fredrikr79/TDT4295-datamaskinprosjekt/mcu/hexMCU/host/test.png

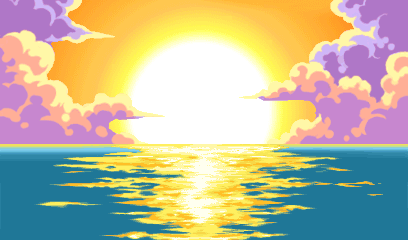
mcu/hexMCU/host/test.png
