fredrikr79/TDT4295-datamaskinprosjekt/documentation/slides/images/noita-background.png

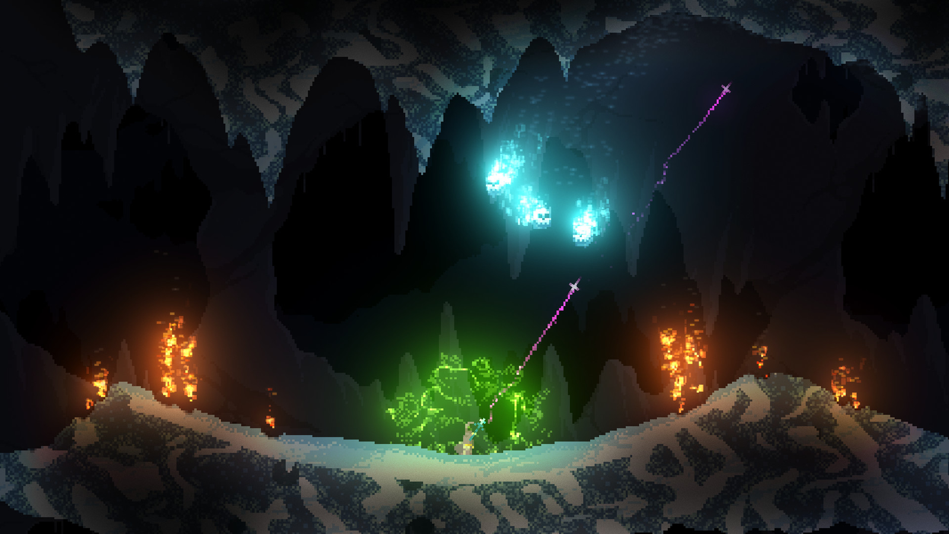
documentation/slides/images/noita-background.png
