fredrikr79/TDT4295-datamaskinprosjekt/README.md

## Structure

### MCU

The source code for the microcontroller

### FPGA

The source code for the FPGA

### PCB

The schematics for the PCB
