fredrikr79/TDT4295-datamaskinprosjekt/pcb/assets/APTF1616LSEEZGKQBKC/APTF1616.STEP

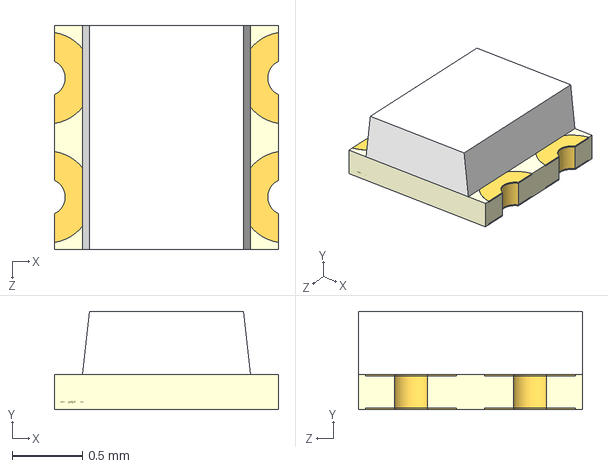
[picture p3: CAD file, 2026-09-30]
pcb/assets/APTF1616LSEEZGKQBKC/APTF1616.STEP
1.60 x 0.7 x 1.60 mm
