fredrikr79/TDT4295-datamaskinprosjekt/pcb/assets/L77HDE15SD1CH4FVGA/L77HDE15SD1CH4FVGA.step

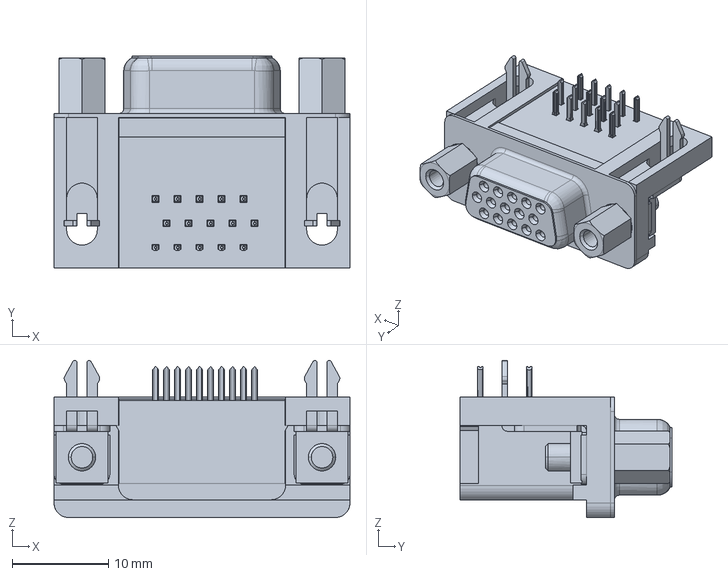
[picture p4: CAD file, 2026-09-28]
pcb/assets/L77HDE15SD1CH4FVGA/L77HDE15SD1CH4FVGA.step
30.8 x 22.1 x 16.3 mm
