fredrikr79/TDT4295-datamaskinprosjekt/pcb/assets/sd_card_model.stp

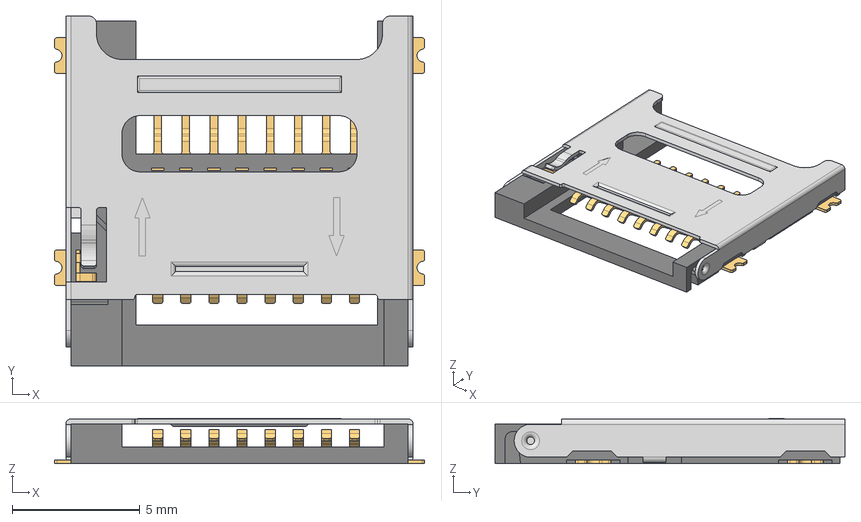
[picture p5: CAD file, 2026-09-29]
pcb/assets/sd_card_model.stp
14.5 x 13.7 x 1.77 mm
693072010801_PIN x 8
693072010801_PATTE x 3
693072010801_CACHE
693072010801_PATTE_SPE
