fredrikr79/TDT4295-datamaskinprosjekt/pcb/assets/ul_TPS54294PWP/PWP0016C.stp

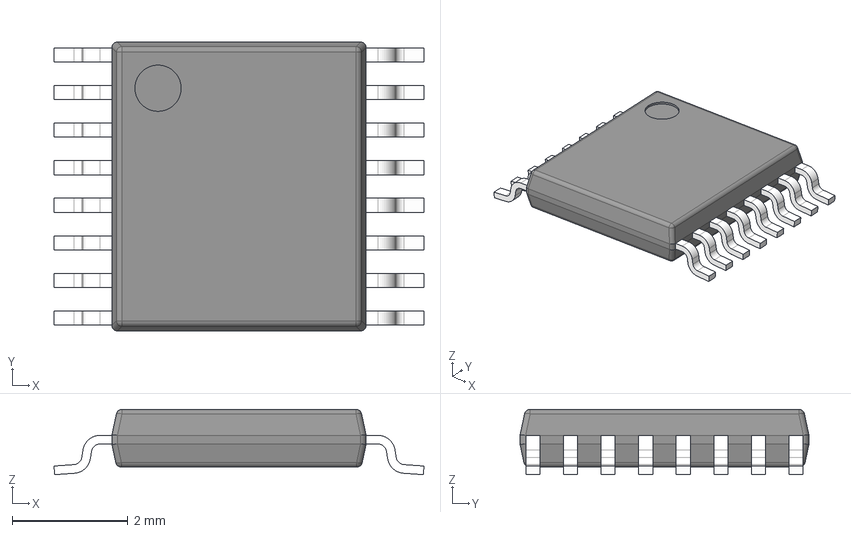
[picture p6: CAD file, 2026-09-28]
pcb/assets/ul_TPS54294PWP/PWP0016C.stp
6.40 x 5.00 x 1.13 mm
BODY-TSSOP
LEAD-TSSOP x 16
PIN1
DAP
