fredrikr79/TDT4295-datamaskinprosjekt/pcb/assets/FTFTG256_XIL.step

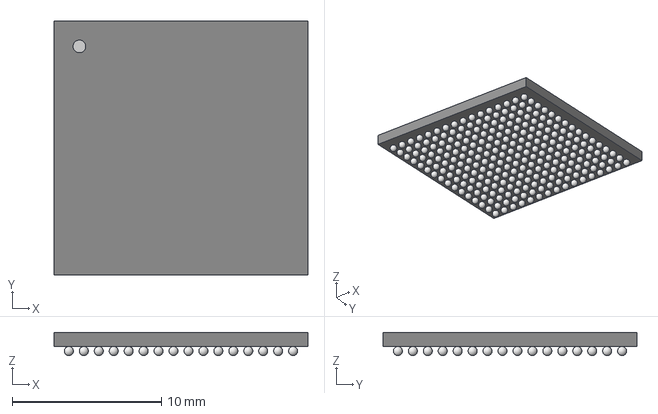
[picture p7: CAD file, 2026-09-29]
pcb/assets/FTFTG256_XIL.step
17.0 x 17.0 x 1.55 mm
