fredrikr79/TDT4295-datamaskinprosjekt/pcb/assets/usb_c_12401826E412A/12401826E412A.step

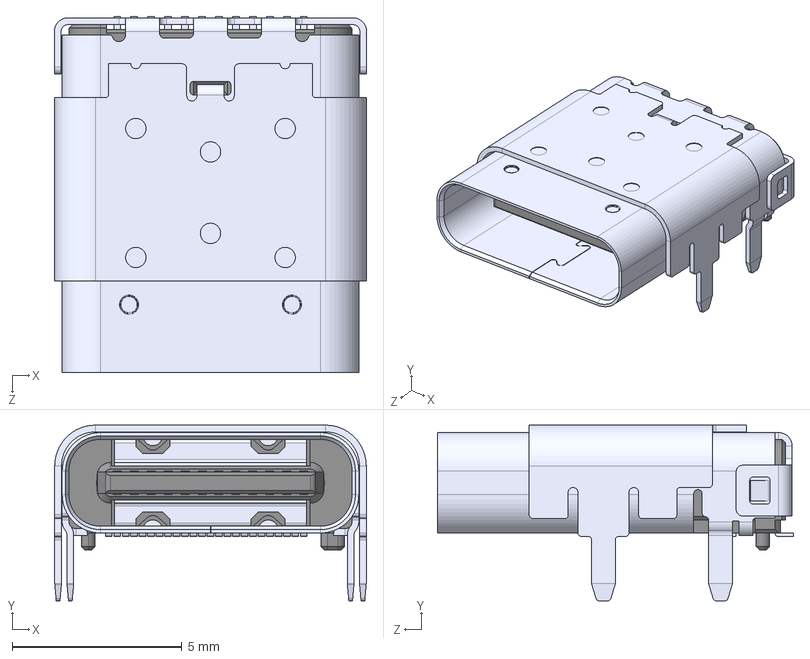
[picture p8: CAD file, 2026-09-11]
pcb/assets/usb_c_12401826E412A/12401826E412A.step
9.20 x 5.18 x 10.5 mm
