fredrikr79/TDT4295-datamaskinprosjekt/(list of files, cad)

Other CAD files:
pcb/assets/ul_TPS54325PWP/PWP0014K.stp
