fredrikr79/TDT4295-datamaskinprosjekt/mapconstructor/src/full/start.png

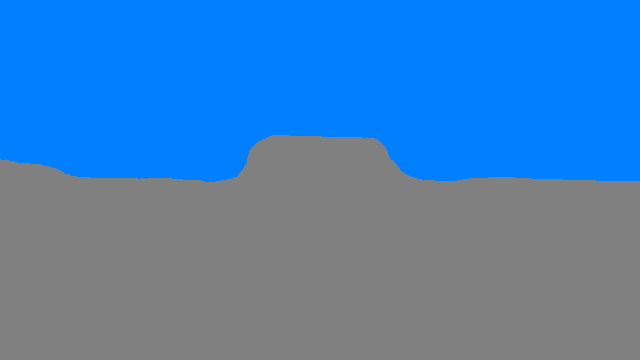
mapconstructor/src/full/start.png
