fredrikr79/TDT4295-datamaskinprosjekt/pcb/tdt4295.pdf

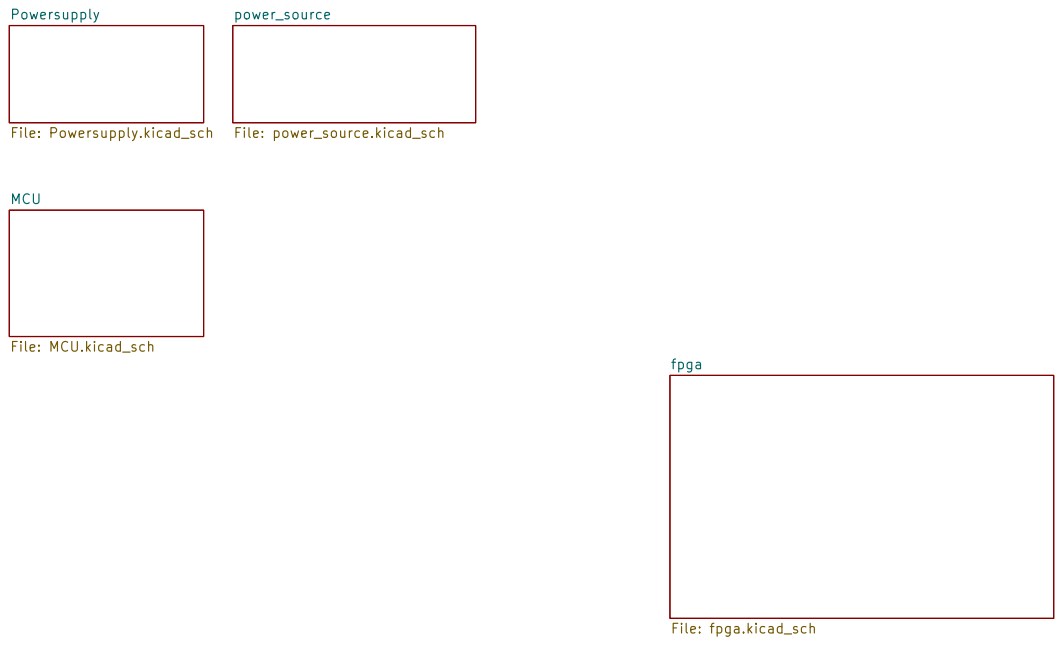
[picture p10: page 1]

File: MCU.kicad_sch Powersupply File: Powersupply.kicad_sch

Size: A4 | Rev:
KiCad E.D.A. 10.0.4 | Id: 1/6

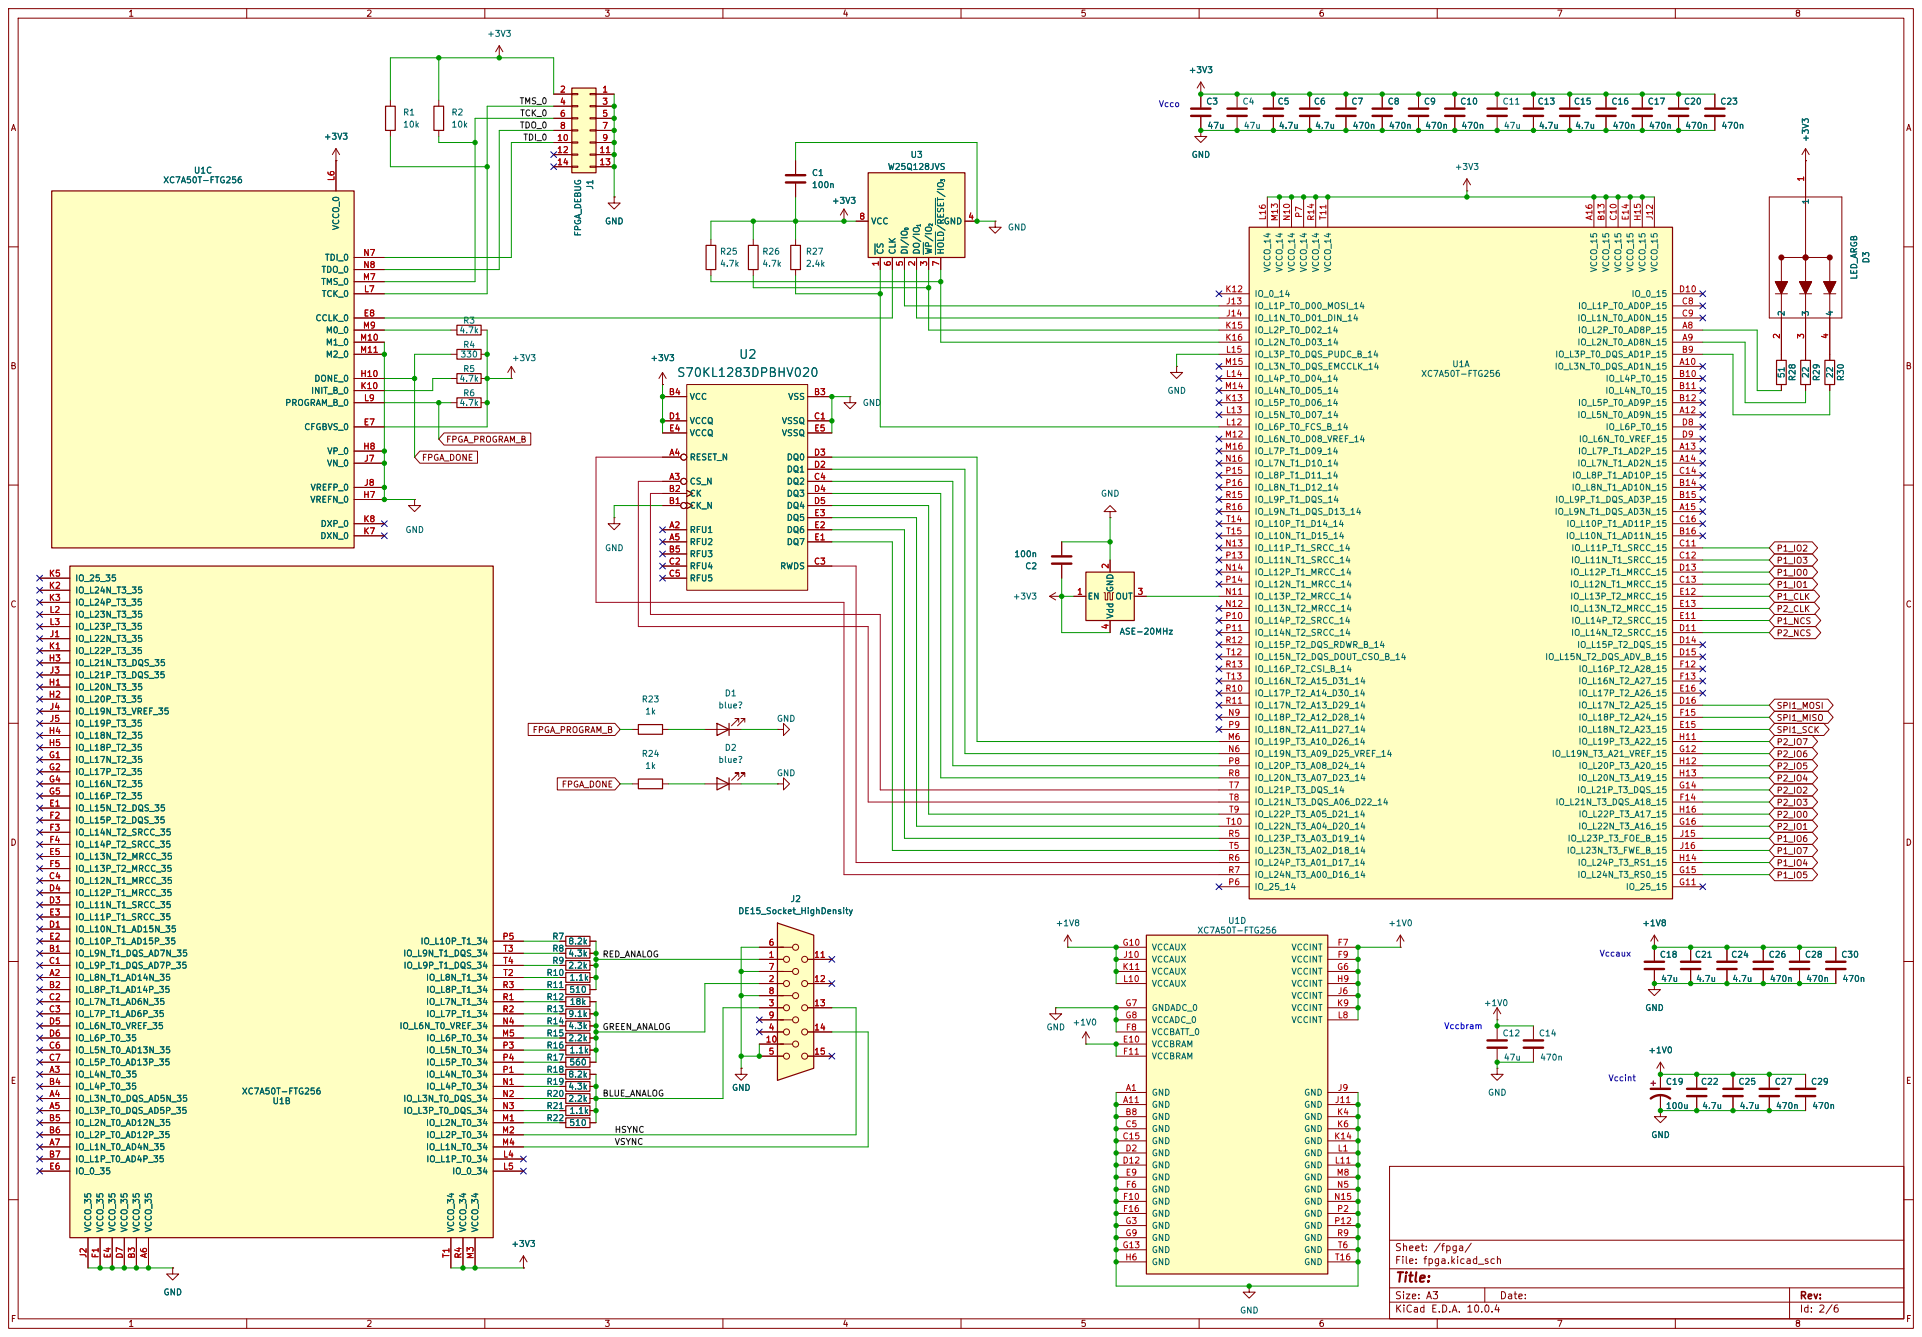
[picture p11: page 2]

TCK_0 6 6 | | 5 5
TDO_0 8 8 | | 7 7
TDI_0 10 10 | | 9 9

1 DO/IO1 2 WP/IO2 3 GND 4 DI/IO0 5 CLK

IO_L1N_T0_D01_DIN_14 J14

IO_L21N_T3_DQS_A06_D22_14 T8
IO_L22P_T3_A05_D21_14 T9

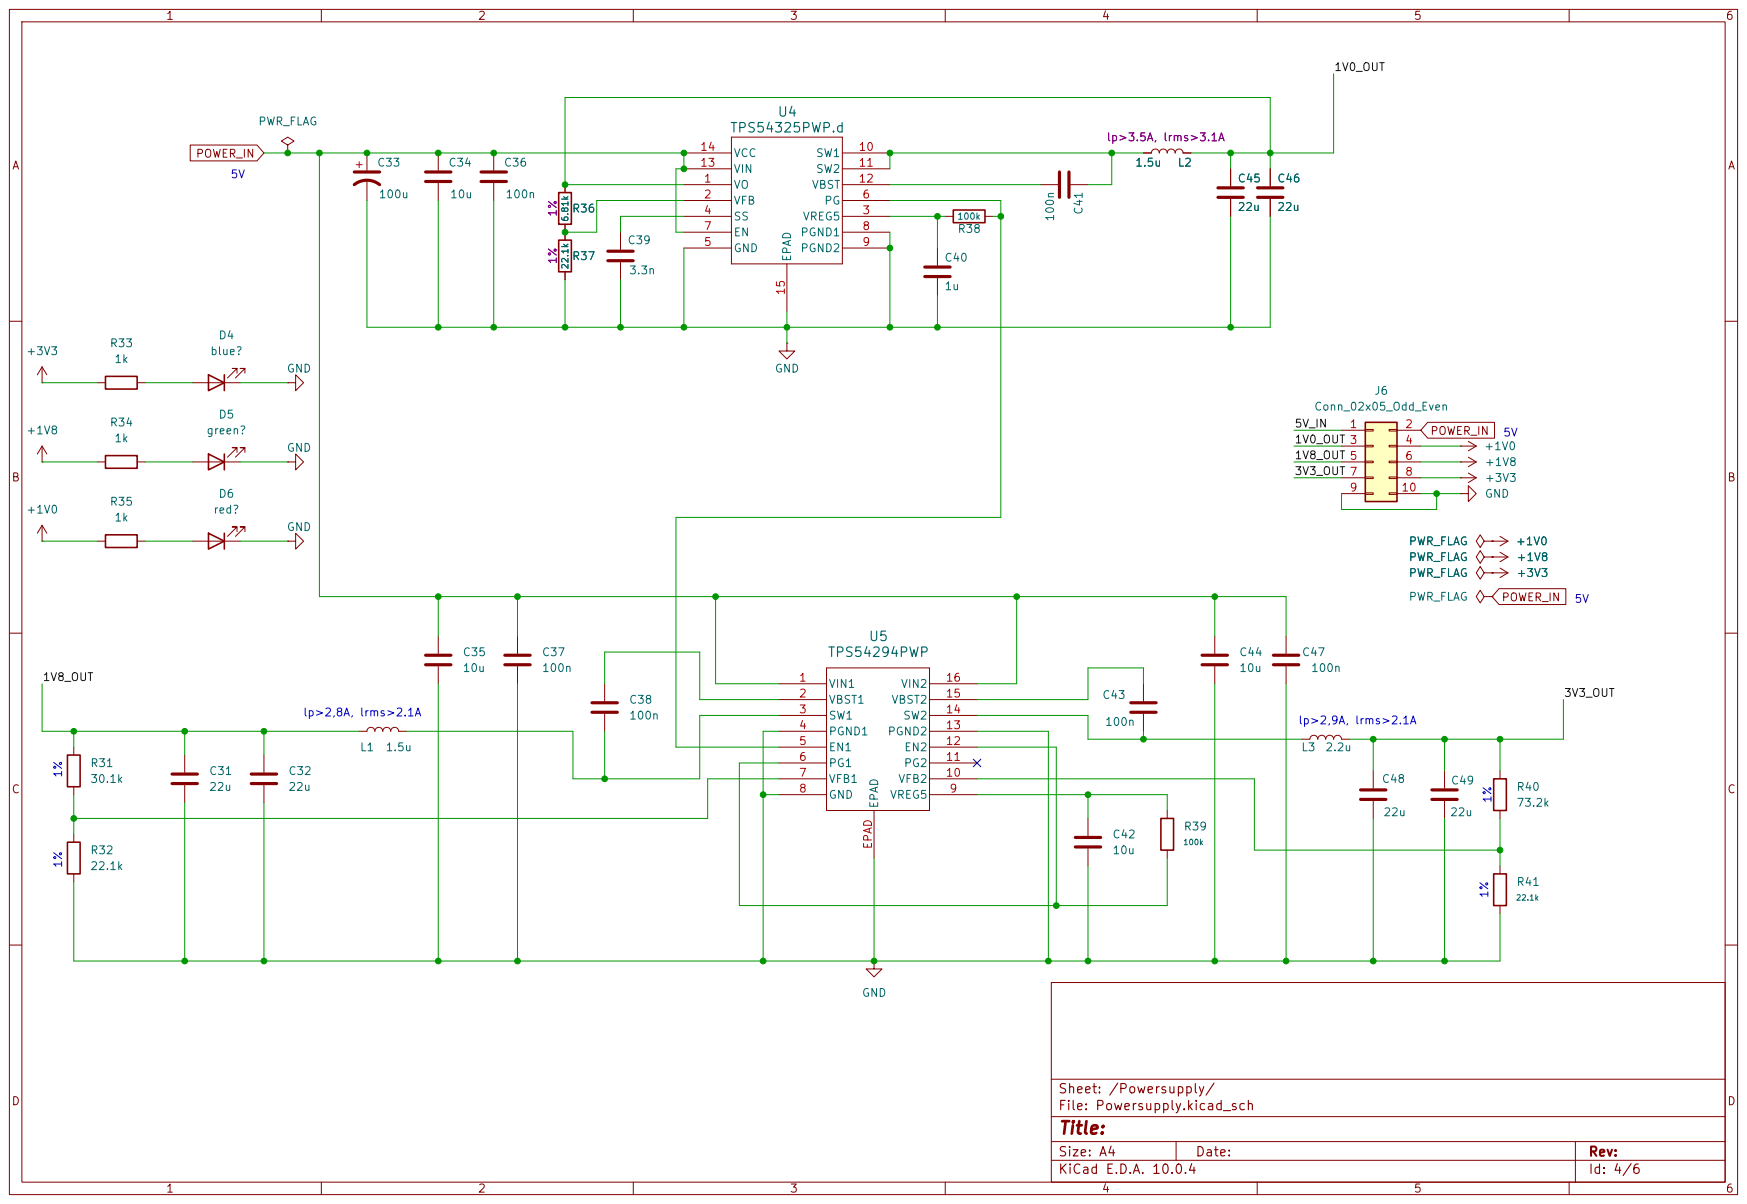
[picture p12: page 3]

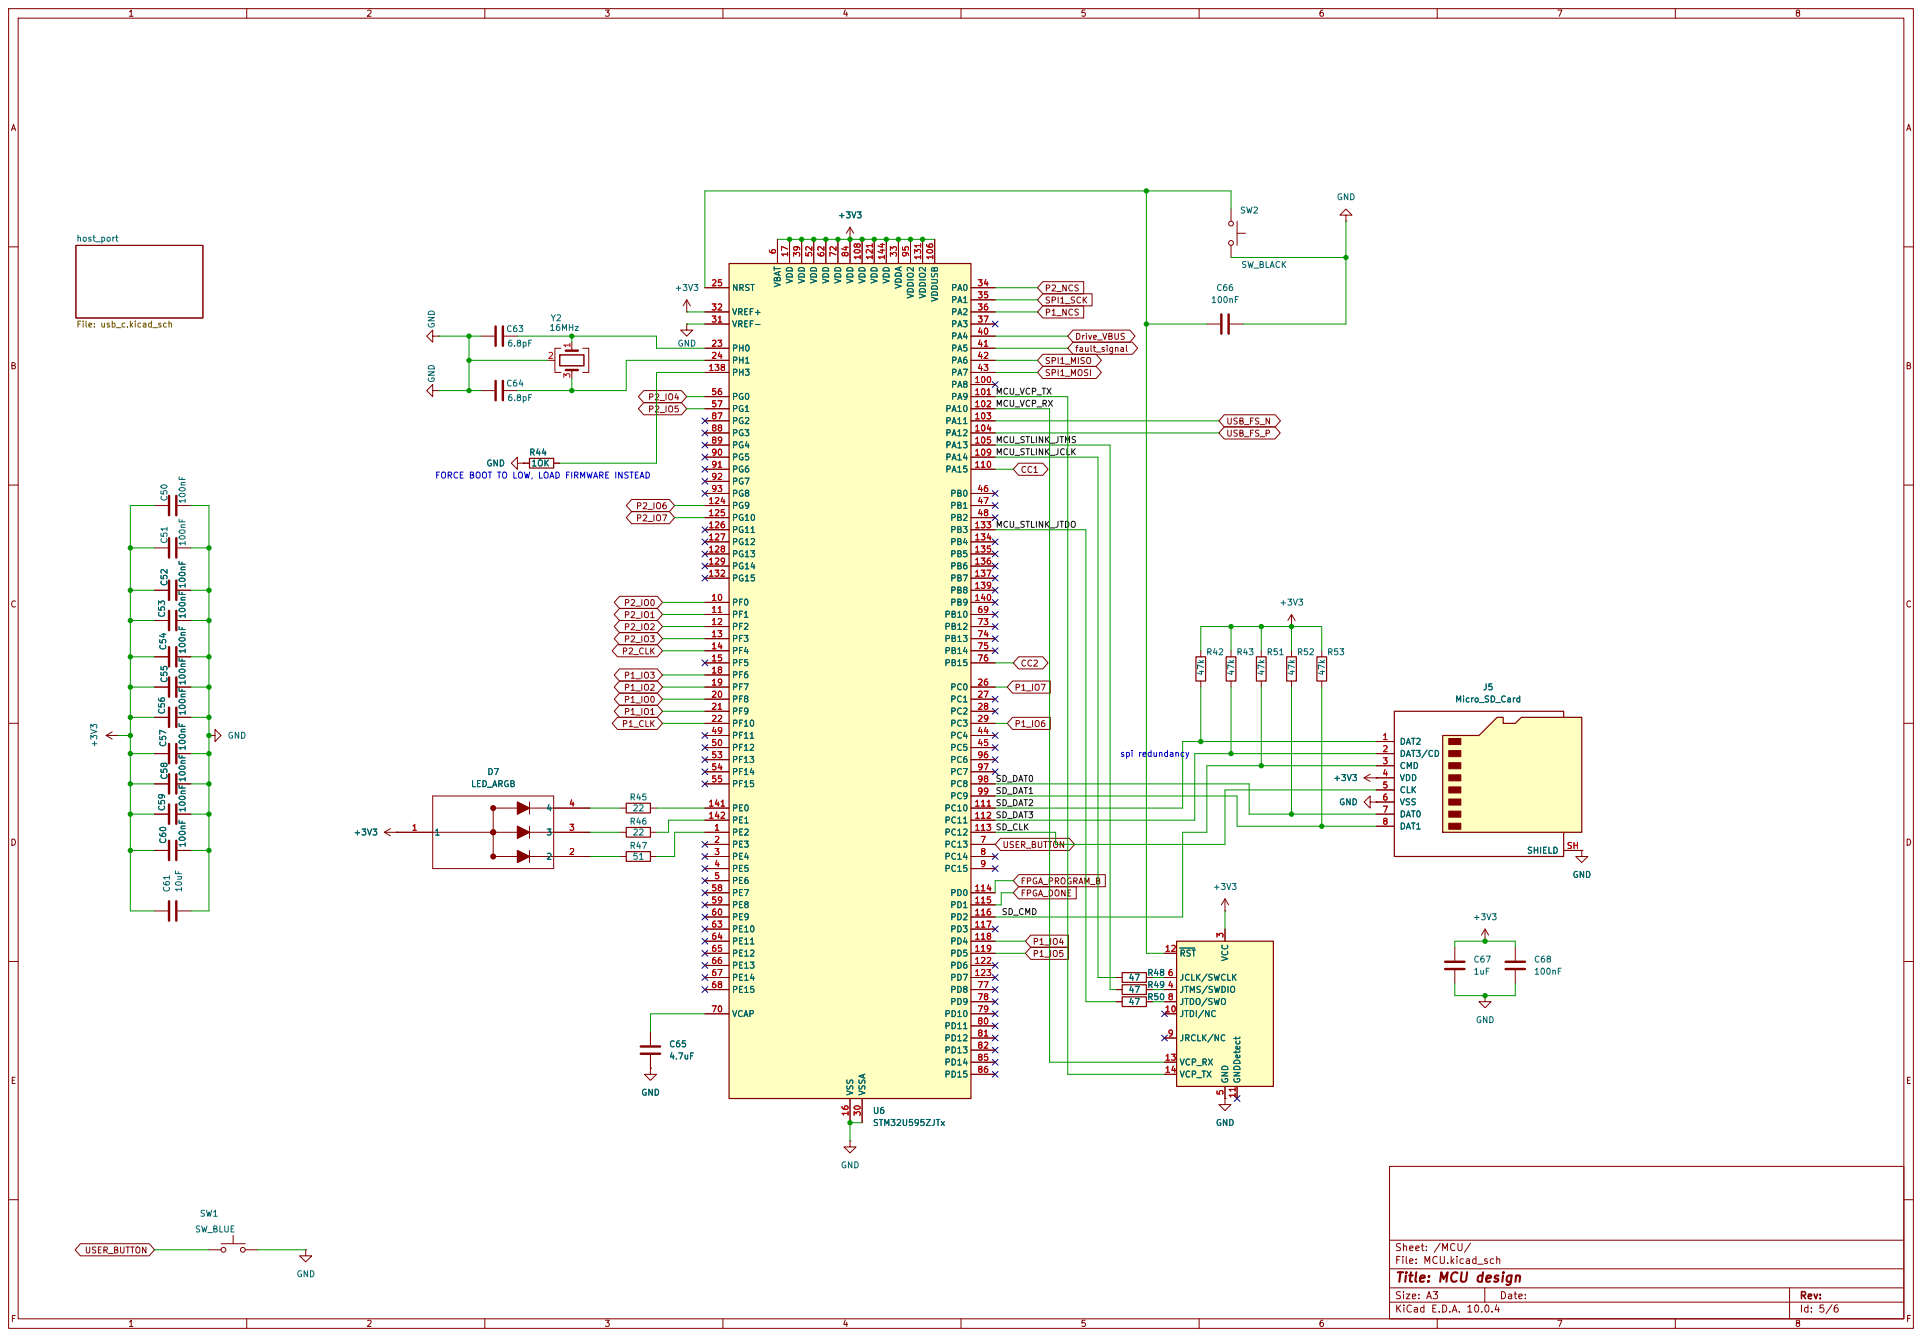
[picture p13: page 4]

SD_CLK MCU_STLINK_JTDO MCU_STLINK_JTMS MCU_VCP_TX MCU_VCP_RX MCU_STLINK_JCLK SD_DAT0

FORCE BOOT TO LOW, LOAD FIRMWARE INSTEAD

DAT2 1 DAT3/CD 2 CMD 3

VDD 4 CLK 5

SD_DAT1
SD_DAT2
SD_DAT3

VSS 6 DAT0 7 DAT1 8

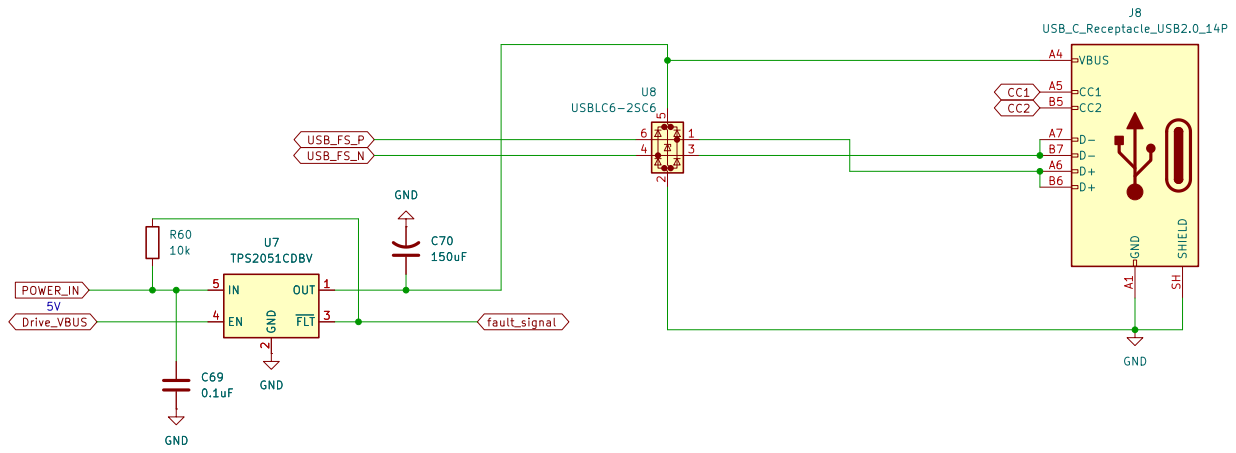
[picture p14: page 5]

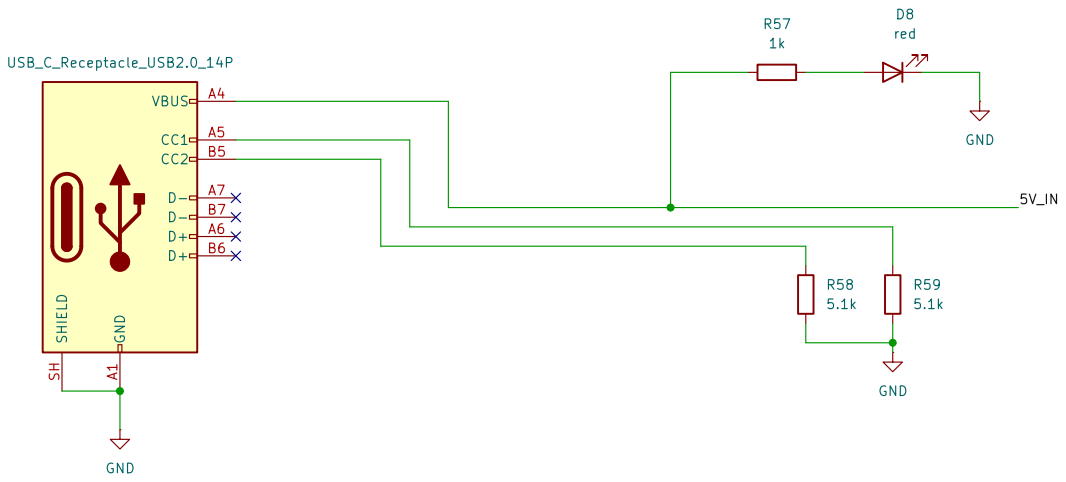
[picture p15: page 6]
