fredrikr79/TDT4295-datamaskinprosjekt/pcb/output.pdf

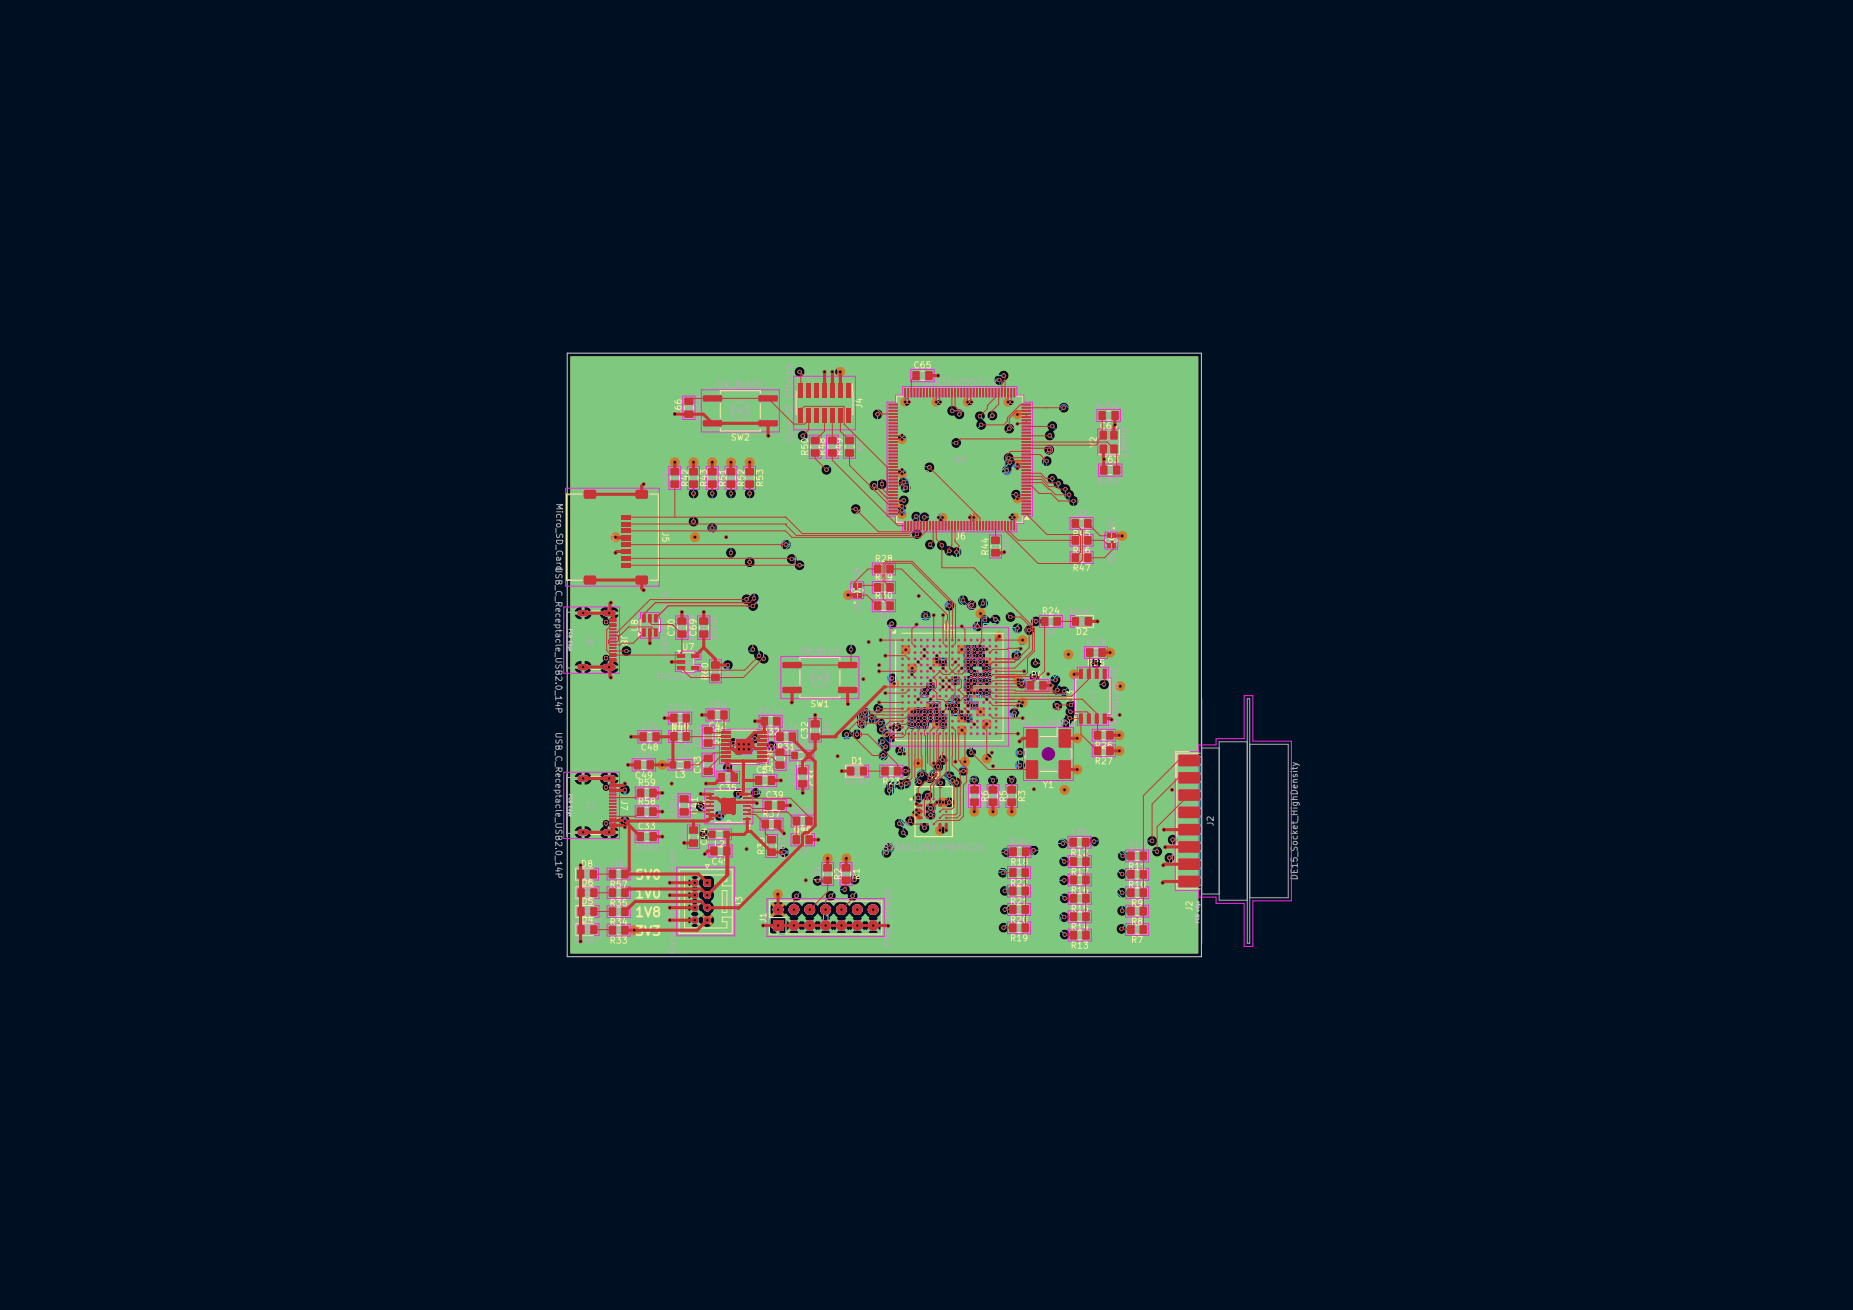
[picture p16: page 1]
