fredrikr79/TDT4295-datamaskinprosjekt/(list of files, drawings)

Other design files:
pcb/assets/S70KL1283DPBHV020/Altium/BGA24C100P5X5_600X800X100.PcbLib
pcb/assets/S70KL1283DPBHV020/Altium/S70KL1283DPBHV020.SchLib
