fredrikr79/TDT4295-datamaskinprosjekt/pcb/tdt4295.kicad_pcb

## KiCad design pcb/tdt4295.kicad_pcb (2026-10-02)

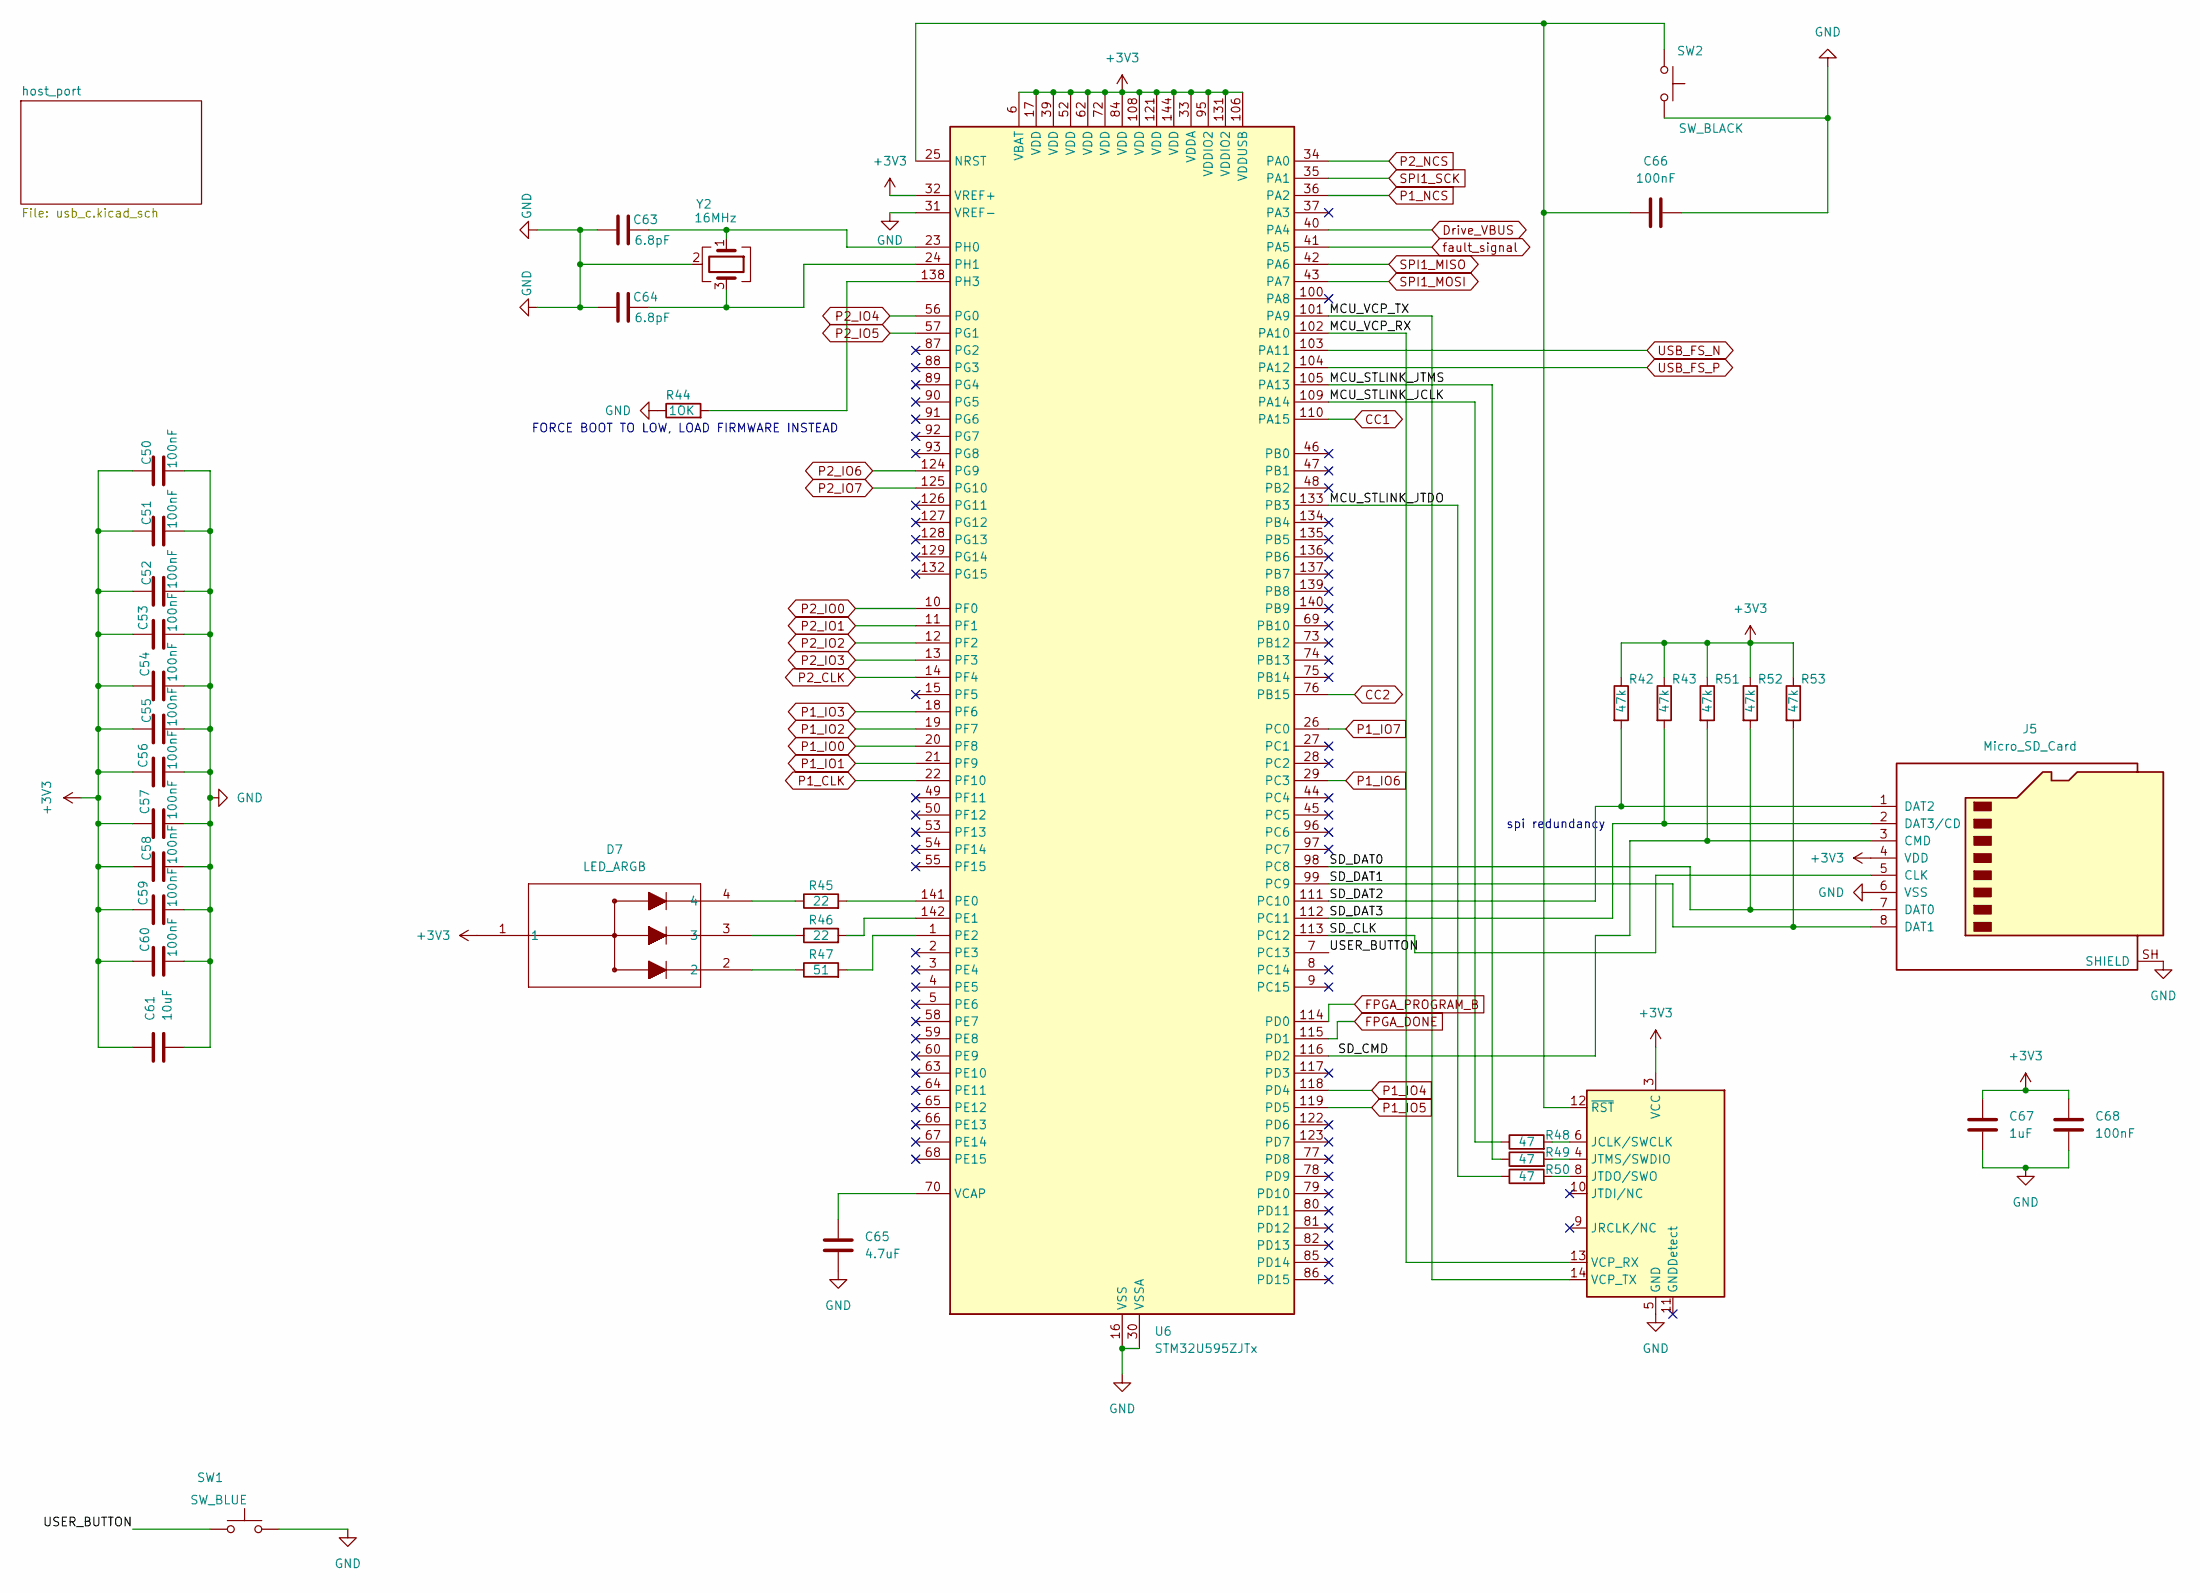
[picture p17: schematic MCU.kicad_sch, MCU design]

Parts:
C50, C51, C52, C53, C54, C55, C56, C57, C58, C59, C60, C66, C68: 100nF; C_0805_2012Metric_Pad1.18x1.45mm_HandSolder
C61: 10uF; C_0805_2012Metric_Pad1.18x1.45mm_HandSolder
C63, C64: 6.8pF; C_0805_2012Metric_Pad1.18x1.45mm_HandSolder
C65: 4.7uF; C_0805_2012Metric_Pad1.18x1.45mm_HandSolder
C67: 1uF; C_0805_2012Metric_Pad1.18x1.45mm_HandSolder
D7: LED_ARGB; SON4_APTF1616LSEEZGKQBKC_KNB
J4: Conn_ST_STDC14; PinHeader_2x07_P1.27mm_Vertical_SMD
J5: Micro_SD_Card; microSD_HC_Molex_47219-2001
R42, R43, R51, R52, R53: 47k; R_0805_2012Metric_Pad1.20x1.40mm_HandSolder
R44: 1OK; R_0805_2012Metric_Pad1.20x1.40mm_HandSolder
R45, R46: 22; R_0805_2012Metric_Pad1.20x1.40mm_HandSolder
R47: 51; R_0805_2012Metric_Pad1.20x1.40mm_HandSolder
R48, R49, R50: 47; R_0805_2012Metric_Pad1.20x1.40mm_HandSolder
SW1: SW_BLUE; SW_Push_1P1T_NO_CK_KSC6xxG
SW2: SW_BLACK; SW_Push_1P1T_NO_CK_KSC6xxG
U6: STM32U595ZJTx; LQFP-144_20x20mm_P0.5mm
Y2: 16MHz; Crystal_SMD_3225-4Pin_3.2x2.5mm

Connections:
+3V3: C50.1, C51.1, C52.1, C53.1, C54.1, C55.1, C56.1, C57.1, C58.1, C59.1, C60.1, C61.1, C67.1, C68.1, D7.1, J4.3 (VCC), J5.4 (VDD), R42.1, R43.1, R51.1, R52.1, R53.1, U6.6 (VBAT), U6.17 (VDD), U6.32 (VREF+), U6.33 (VDDA), U6.39 (VDD), U6.52 (VDD), U6.62 (VDD), U6.72 (VDD), U6.84 (VDD), U6.95 (VDDIO2), U6.106 (VDDUSB), U6.108 (VDD), U6.121 (VDD), U6.131 (VDDIO2), U6.144 (VDD); also elsewhere on the board
/MCU/MCU_STLINK_JCLK: R48.1, U6.109 (PA14)
/MCU/MCU_STLINK_JTDO: R50.1, U6.133 (PB3)
/MCU/MCU_STLINK_JTMS: R49.1, U6.105 (PA13)
/MCU/MCU_VCP_RX: J4.13 (VCP_RX), U6.102 (PA10)
/MCU/MCU_VCP_TX: J4.14 (VCP_TX), U6.101 (PA9)
/MCU/SD_CLK: J5.5 (CLK), U6.113 (PC12)
/MCU/SD_CMD: J5.3 (CMD), R51.2, U6.116 (PD2)
/MCU/SD_DAT0: J5.7 (DAT0), R52.2, U6.98 (PC8)
/MCU/SD_DAT1: J5.8 (DAT1), R53.2, U6.99 (PC9)
/MCU/SD_DAT2: J5.1 (DAT2), R42.2, U6.111 (PC10)
/MCU/SD_DAT3: J5.2 (DAT3/CD), R43.2, U6.112 (PC11)
/MCU/USER_BUTTON: SW1.1, U6.7 (PC13)
CC1: U6.110 (PA15); also elsewhere on the board
CC2: U6.76 (PB15); also elsewhere on the board
Drive_VBUS: U6.40 (PA4); also elsewhere on the board
FPGA_DONE: U6.115 (PD1); also elsewhere on the board
FPGA_PROGRAM_B: U6.114 (PD0); also elsewhere on the board
GND: C50.2, C51.2, C52.2, C53.2, C54.2, C55.2, C56.2, C57.2, C58.2, C59.2, C60.2, C61.2, C63.1, C64.1, C65.2, C66.1, C67.2, C68.2, J4.5 (GND), J4.7 (GND), J5.6 (VSS), J5.SH (SHIELD), R44.1, SW1.2, SW2.2, U6.16 (VSS), U6.30 (VSSA), U6.31 (VREF-), U6.38 (VSS), U6.51 (VSS), U6.61 (VSS), U6.71 (VSS), U6.83 (VSS), U6.94 (VSS), U6.107 (VSS), U6.120 (VSS), U6.130 (VSS), U6.143 (VSS), Y2.2 (G), Y2.4 (G); also elsewhere on the board
unnamed: D7.2, R47.1
unnamed: D7.3, R46.1
unnamed: D7.4, R45.1
unnamed: J4.6 (JCLK/SWCLK), R48.2
unnamed: J4.8 (JTDO/SWO), R50.2
unnamed: J4.4 (JTMS/SWDIO), R49.2
unnamed: C66.2, J4.12 (~RST), SW2.1, U6.25 (NRST)
unnamed: R45.2, U6.141 (PE0)
unnamed: R46.2, U6.142 (PE1)
unnamed: R47.2, U6.1 (PE2)
unnamed: C63.2, U6.23 (PH0), Y2.1
unnamed: C64.2, U6.24 (PH1), Y2.3
unnamed: R44.2, U6.138 (PH3)
unnamed: C65.1, U6.70 (VCAP)
P1_CLK: U6.22 (PF10); also elsewhere on the board
P1_IO0: U6.20 (PF8); also elsewhere on the board
P1_IO1: U6.21 (PF9); also elsewhere on the board
P1_IO2: U6.19 (PF7); also elsewhere on the board
P1_IO3: U6.18 (PF6); also elsewhere on the board
P1_IO4: U6.118 (PD4); also elsewhere on the board
P1_IO5: U6.119 (PD5); also elsewhere on the board
P1_IO6: U6.29 (PC3); also elsewhere on the board
P1_IO7: U6.26 (PC0); also elsewhere on the board
P1_NCS: U6.36 (PA2); also elsewhere on the board
P2_CLK: U6.14 (PF4); also elsewhere on the board
P2_IO0: U6.10 (PF0); also elsewhere on the board
P2_IO1: U6.11 (PF1); also elsewhere on the board
P2_IO2: U6.12 (PF2); also elsewhere on the board
P2_IO3: U6.13 (PF3); also elsewhere on the board
P2_IO4: U6.56 (PG0); also elsewhere on the board
P2_IO5: U6.57 (PG1); also elsewhere on the board
P2_IO6: U6.124 (PG9); also elsewhere on the board
P2_IO7: U6.125 (PG10); also elsewhere on the board
P2_NCS: U6.34 (PA0); also elsewhere on the board
SPI1_MISO: U6.42 (PA6); also elsewhere on the board
SPI1_MOSI: U6.43 (PA7); also elsewhere on the board
SPI1_SCK: U6.35 (PA1); also elsewhere on the board
USB_FS_N: U6.103 (PA11); also elsewhere on the board
USB_FS_P: U6.104 (PA12); also elsewhere on the board
fault_signal: U6.41 (PA5); also elsewhere on the board

Notes on the sheet:
FORCE BOOT TO LOW, LOAD FIRMWARE INSTEAD
spi redundancy

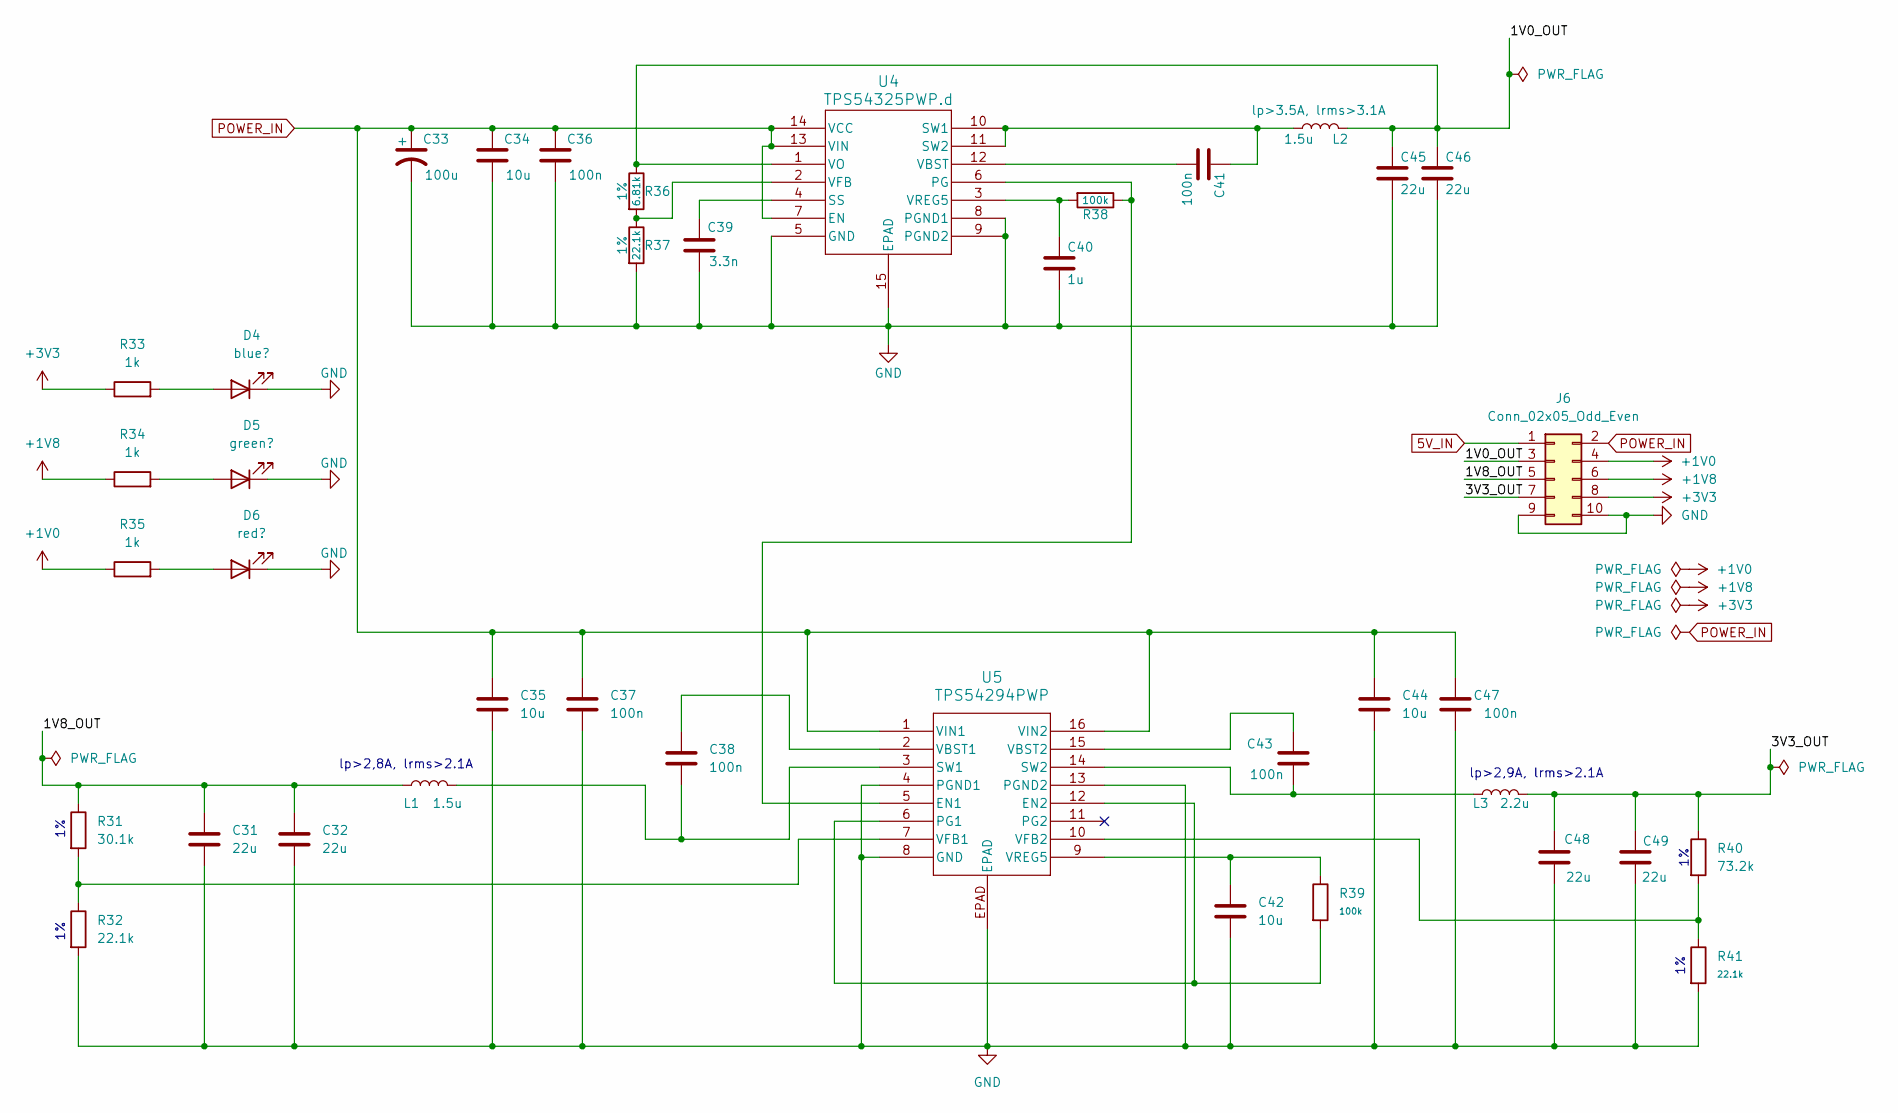
[picture p18: schematic Powersupply.kicad_sch]

Parts:
C31, C32, C45, C46, C48, C49: 22u; C_0805_2012Metric_Pad1.18x1.45mm_HandSolder
C33: 100u; C_0805_2012Metric_Pad1.18x1.45mm_HandSolder
C34, C35, C42, C44: 10u; C_0805_2012Metric_Pad1.18x1.45mm_HandSolder
C36, C37, C38, C41, C43, C47: 100n; C_0805_2012Metric_Pad1.18x1.45mm_HandSolder
C39: 3.3n; C_0805_2012Metric_Pad1.18x1.45mm_HandSolder
C40: 1u; C_0805_2012Metric_Pad1.18x1.45mm_HandSolder
D4: blue?; LED_0805_2012Metric_Pad1.15x1.40mm_HandSolder
D5: green?; LED_0805_2012Metric_Pad1.15x1.40mm_HandSolder
D6: red?; LED_0805_2012Metric_Pad1.15x1.40mm_HandSolder
J6: Conn_02x05_Odd_Even; PinHeader_2x05_P2.54mm_Vertical
L1, L2: 1.5u; L_0805_2012Metric_Pad1.05x1.20mm_HandSolder
L3: 2.2u; L_0805_2012Metric_Pad1.05x1.20mm_HandSolder
R31: 30.1k; R_0805_2012Metric_Pad1.20x1.40mm_HandSolder
R32, R37, R41: 22.1k; R_0805_2012Metric_Pad1.20x1.40mm_HandSolder
R33, R34, R35: 1k; R_0805_2012Metric_Pad1.20x1.40mm_HandSolder
R36: 6.81k; R_0805_2012Metric_Pad1.20x1.40mm_HandSolder
R38, R39: 100k; R_0805_2012Metric_Pad1.20x1.40mm_HandSolder
R40: 73.2k; R_0805_2012Metric_Pad1.20x1.40mm_HandSolder
U4: TPS54325PWP.d; PWP14_2P31X2P46
U5: TPS54294PWP; PWP16_2P31X2P46

Connections:
5V_IN: J6.1; also elsewhere on the board
+1V0: J6.4, R35.1; also elsewhere on the board
+1V8: J6.6, R34.1; also elsewhere on the board
+3V3: J6.8, R33.1; also elsewhere on the board
/Powersupply/1V0_OUT: C45.1, C46.1, J6.3, L2.1, R36.1, U4.1 (VO)
/Powersupply/1V8_OUT: C31.1, C32.1, J6.5, L1.1, R31.1
/Powersupply/3V3_OUT: C48.1, C49.1, J6.7, L3.2, R40.1
GND: C31.2, C32.2, C33.2, C34.2, C35.2, C36.2, C37.2, C39.2, C40.2, C42.2, C44.2, C45.2, C46.2, C47.2, C48.2, C49.2, D4.1 (K), D5.1 (K), D6.1 (K), J6.9, J6.10, R32.2, R37.2, R41.2, U4.5 (GND), U4.8 (PGND1), U4.9 (PGND2), U4.15 (EPAD), U5.4 (PGND1), U5.8 (GND), U5.13 (PGND2), U5.EPAD; also elsewhere on the board
unnamed: D4.2 (A), R33.2
unnamed: D5.2 (A), R34.2
unnamed: D6.2 (A), R35.2
unnamed: R38.1, U4.6 (PG), U5.5 (EN1)
unnamed: C39.1, U4.4 (SS)
unnamed: C41.1, L2.2, U4.10 (SW1), U4.11 (SW2)
unnamed: C41.2, U4.12 (VBST)
unnamed: R36.2, R37.1, U4.2 (VFB)
unnamed: C40.1, R38.2, U4.3 (VREG5)
unnamed: R39.2, U5.6 (PG1), U5.12 (EN2)
unnamed: C38.2, L1.2, U5.3 (SW1)
unnamed: C43.2, L3.1, U5.14 (SW2)
unnamed: C38.1, U5.2 (VBST1)
unnamed: C43.1, U5.15 (VBST2)
unnamed: R31.2, R32.1, U5.7 (VFB1)
unnamed: R40.2, R41.1, U5.10 (VFB2)
unnamed: C42.1, R39.1, U5.9 (VREG5)
POWER_IN: C33.1, C34.1, C35.1, C36.1, C37.1, C44.1, C47.1, J6.2, U4.7 (EN), U4.13 (VIN), U4.14 (VCC), U5.1 (VIN1), U5.16 (VIN2); also elsewhere on the board

Notes on the sheet:
lp>2,9A, lrms>2.1A
lp>2,8A, lrms>2.1A

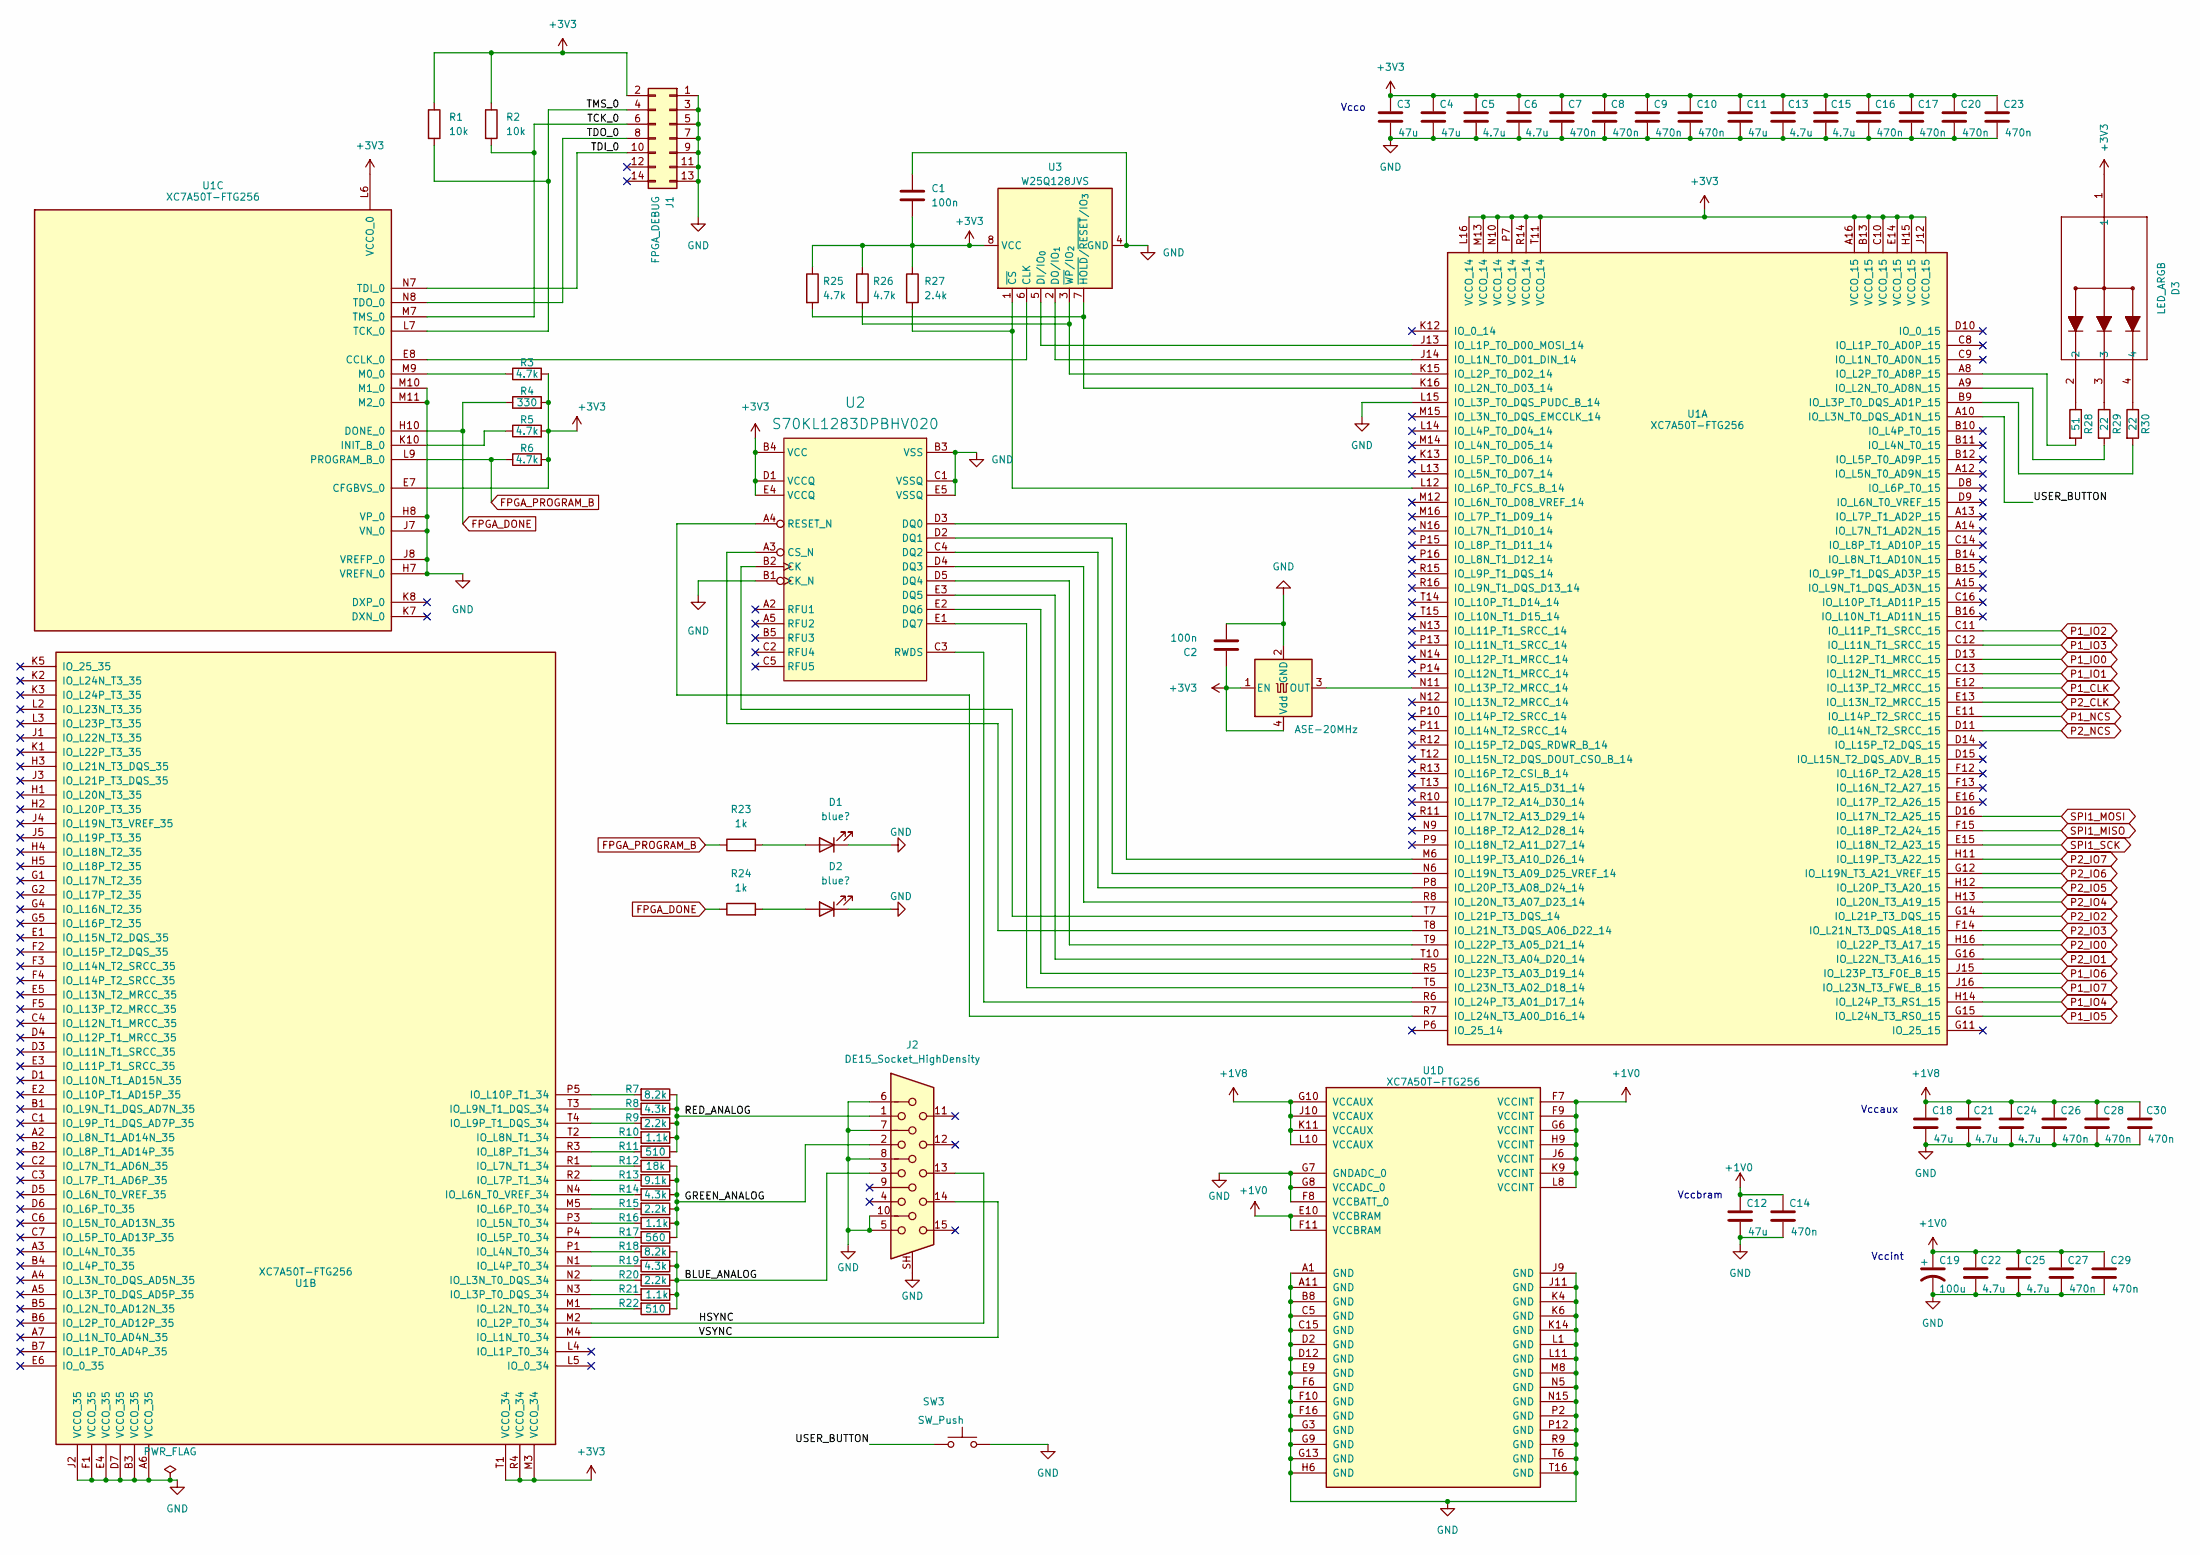
[picture p19: schematic fpga.kicad_sch]

Parts:
C1, C2: 100n; C_0805_2012Metric_Pad1.18x1.45mm_HandSolder
C3, C4, C11, C12, C18: 47u; C_0805_2012Metric_Pad1.18x1.45mm_HandSolder
C5, C6, C13, C15, C21, C22, C24, C25: 4.7u; C_0805_2012Metric_Pad1.18x1.45mm_HandSolder
C7, C8, C9, C10, C14, C16, C17, C20, C23, C26, C27, C28, C29, C30: 470n; C_0805_2012Metric_Pad1.18x1.45mm_HandSolder
C19: 100u; C_0805_2012Metric_Pad1.18x1.45mm_HandSolder
D1, D2: blue?; LED_0805_2012Metric_Pad1.15x1.40mm_HandSolder
D3: LED_ARGB; SON4_APTF1616LSEEZGKQBKC_KNB
J1: FPGA_DEBUG; PinHeader_2x07_P2.54mm_Vertical
J2: DE15_Socket_HighDensity; AMPHENOL_L77HDE15SD1CH4FVGA
R1, R2: 10k; R_0805_2012Metric_Pad1.20x1.40mm_HandSolder
R3, R5, R6, R25, R26: 4.7k; R_0805_2012Metric_Pad1.20x1.40mm_HandSolder
R4: 330; R_0805_2012Metric_Pad1.20x1.40mm_HandSolder
R7, R18: 8.2k; R_0805_2012Metric_Pad1.20x1.40mm_HandSolder
R8, R14, R19: 4.3k; R_0805_2012Metric_Pad1.20x1.40mm_HandSolder
R9, R15, R20: 2.2k; R_0805_2012Metric_Pad1.20x1.40mm_HandSolder
R10, R16, R21: 1.1k; R_0805_2012Metric_Pad1.20x1.40mm_HandSolder
R11, R22: 510; R_0805_2012Metric_Pad1.20x1.40mm_HandSolder
R12: 18k; R_0805_2012Metric_Pad1.20x1.40mm_HandSolder
R13: 9.1k; R_0805_2012Metric_Pad1.20x1.40mm_HandSolder
R17: 560; R_0805_2012Metric_Pad1.20x1.40mm_HandSolder
R23, R24: 1k; R_0805_2012Metric_Pad1.20x1.40mm_HandSolder
R27: 2.4k; R_0805_2012Metric_Pad1.20x1.40mm_HandSolder
R28: 51; R_0805_2012Metric_Pad1.20x1.40mm_HandSolder
R29, R30: 22; R_0805_2012Metric_Pad1.20x1.40mm_HandSolder
SW3: SW_Push; SW_Push_1P1T_NO_CK_KSC6xxG
U1: XC7A50T-FTG256; Xilinx_FTG256
U2: S70KL1283DPBHV020; BGA24C100P5X5_600X800X100
U3: W25Q128JVS; SOIC-8_5.3x5.3mm_P1.27mm
Y1: ASE-20MHz; Oscillator_SMD_Abracon_ASV-4Pin_7.0x5.1mm_HandSoldering

Connections:
+1V0: C12.1, C14.1, C19.1, C22.1, C25.1, C27.1, C29.1, U1.E10 (VCCBRAM), U1.F7 (VCCINT), U1.F9 (VCCINT), U1.F11 (VCCBRAM), U1.G6 (VCCINT), U1.H9 (VCCINT), U1.J6 (VCCINT), U1.K9 (VCCINT), U1.L8 (VCCINT); also elsewhere on the board
+1V8: C18.1, C21.1, C24.1, C26.1, C28.1, C30.1, U1.G10 (VCCAUX), U1.J10 (VCCAUX), U1.K11 (VCCAUX), U1.L10 (VCCAUX); also elsewhere on the board
+3V3: C1.2, C2.1, C3.1, C4.1, C5.1, C6.1, C7.1, C8.1, C9.1, C10.1, C11.1, C13.1, C15.1, C16.1, C17.1, C20.1, C23.1, D3.1, J1.2, R1.1, R2.1, R3.2, R4.2, R5.2, R6.2, R25.1, R26.1, R27.1, U1.A16 (VCCO_15), U1.B13 (VCCO_15), U1.C10 (VCCO_15), U1.E7 (CFGBVS_0), U1.E14 (VCCO_15), U1.H15 (VCCO_15), U1.J12 (VCCO_15), U1.L6 (VCCO_0), U1.L16 (VCCO_14), U1.M3 (VCCO_34), U1.M13 (VCCO_14), U1.N10 (VCCO_14), U1.P7 (VCCO_14), U1.R4 (VCCO_34), U1.R14 (VCCO_14), U1.T1 (VCCO_34), U1.T11 (VCCO_14), U2.B4 (VCC), U2.D1 (VCCQ), U2.E4 (VCCQ), U3.8 (VCC), Y1.1 (EN), Y1.4 (Vdd); also elsewhere on the board
/fpga/BLUE_ANALOG: J2.3, R18.1, R19.1, R20.1, R21.1, R22.1
/fpga/GREEN_ANALOG: J2.2, R12.1, R13.1, R14.1, R15.1, R16.1, R17.1
/fpga/HSYNC: J2.13, U1.M2 (IO_L2P_T0_34)
/fpga/RED_ANALOG: J2.1, R7.1, R8.1, R9.1, R10.1, R11.1
/fpga/TCK_0: J1.6, R2.2, U1.M7 (TMS_0)
/fpga/TDI_0: J1.10, U1.N7 (TDI_0)
/fpga/TDO_0: J1.8, U1.N8 (TDO_0)
/fpga/TMS_0: J1.4, R1.2, U1.L7 (TCK_0)
/fpga/USER_BUTTON: SW3.1, U1.A10 (IO_L3N_T0_DQS_AD1N_15)
/fpga/VSYNC: J2.14, U1.M4 (IO_L1N_T0_34)
FPGA_DONE: R4.1, R24.1, U1.H10 (DONE_0); also elsewhere on the board
FPGA_PROGRAM_B: R6.1, R23.1, U1.L9 (PROGRAM_B_0); also elsewhere on the board
GND: C1.1, C2.2, C3.2, C4.2, C5.2, C6.2, C7.2, C8.2, C9.2, C10.2, C11.2, C12.2, C13.2, C14.2, C15.2, C16.2, C17.2, C18.2, C19.2, C20.2, C21.2, C22.2, C23.2, C24.2, C25.2, C26.2, C27.2, C28.2, C29.2, C30.2, D1.1 (K), D2.1 (K), J1.1, J1.3, J1.5, J1.7, J1.9, J1.11, J1.13, J2.5, J2.6, J2.7, J2.8, J2.10, J2.SH, SW3.2, U1.A1 (GND), U1.A6 (VCCO_35), U1.A11 (GND), U1.B3 (VCCO_35), U1.B8 (GND), U1.C5 (GND), U1.C15 (GND), U1.D2 (GND), U1.D7 (VCCO_35), U1.D12 (GND), U1.E4 (VCCO_35), U1.E9 (GND), U1.F1 (VCCO_35), U1.F6 (GND), U1.F8 (VCCBATT_0), U1.F10 (GND), U1.F16 (GND), U1.G3 (GND), U1.G7 (GNDADC_0), U1.G8 (VCCADC_0), U1.G9 (GND), U1.G13 (GND), U1.H6 (GND), U1.H7 (VREFN_0), U1.H8 (VP_0), U1.J2 (VCCO_35), U1.J7 (VN_0), U1.J8 (VREFP_0), U1.J9 (GND), U1.J11 (GND), U1.K4 (GND), U1.K6 (GND), U1.K14 (GND), U1.L1 (GND), U1.L11 (GND), U1.L15 (IO_L3P_T0_DQS_PUDC_B_14), U1.M8 (GND), U1.M10 (M1_0), U1.M11 (M2_0), U1.N5 (GND), U1.N15 (GND), U1.P2 (GND), U1.P12 (GND), U1.R9 (GND), U1.T6 (GND), U1.T16 (GND), U2.B1 (CK_N), U2.B3 (VSS), U2.C1 (VSSQ), U2.E5 (VSSQ), U3.4 (GND), Y1.2 (GND); also elsewhere on the board
unnamed: D1.2 (A), R23.2
unnamed: D2.2 (A), R24.2
unnamed: D3.2, R28.1
unnamed: D3.3, R29.1
unnamed: D3.4, R30.1
unnamed: U1.J14 (IO_L1N_T0_D01_DIN_14), U3.2 (DO/IO_{1})
unnamed: U1.J13 (IO_L1P_T0_D00_MOSI_14), U3.5 (DI/IO_{0})
unnamed: R29.2, U1.A9 (IO_L2N_T0_AD8N_15)
unnamed: R25.2, U1.K16 (IO_L2N_T0_D03_14), U3.7 (~HOLD/~RESET/IO_{3})
unnamed: R28.2, U1.A8 (IO_L2P_T0_AD8P_15)
unnamed: R26.2, U1.K15 (IO_L2P_T0_D02_14), U3.3 (~WP/IO_{2})
unnamed: R30.2, U1.B9 (IO_L3P_T0_DQS_AD1P_15)
unnamed: R27.2, U1.L12 (IO_L6P_T0_FCS_B_14), U3.1 (~CS)
unnamed: U1.N11 (IO_L13P_T2_MRCC_14), Y1.3 (OUT)
unnamed: U1.N6 (IO_L19N_T3_A09_D25_VREF_14), U2.D2 (DQ1)
unnamed: U1.M6 (IO_L19P_T3_A10_D26_14), U2.D3 (DQ0)
unnamed: U1.R8 (IO_L20N_T3_A07_D23_14), U2.D4 (DQ3)
unnamed: U1.P8 (IO_L20P_T3_A08_D24_14), U2.C4 (DQ2)
unnamed: U1.T8 (IO_L21N_T3_DQS_A06_D22_14), U2.A3 (CS_N)
unnamed: U1.T7 (IO_L21P_T3_DQS_14), U2.B2 (CK)
unnamed: U1.T10 (IO_L22N_T3_A04_D20_14), U2.E3 (DQ5)
unnamed: U1.T9 (IO_L22P_T3_A05_D21_14), U2.D5 (DQ4)
unnamed: U1.T5 (IO_L23N_T3_A02_D18_14), U2.E1 (DQ7)
unnamed: U1.R5 (IO_L23P_T3_A03_D19_14), U2.E2 (DQ6)
unnamed: U1.R7 (IO_L24N_T3_A00_D16_14), U2.A4 (RESET_N)
unnamed: U1.R6 (IO_L24P_T3_A01_D17_14), U2.C3 (RWDS)
unnamed: R22.2, U1.M1 (IO_L2N_T0_34)
unnamed: R20.2, U1.N2 (IO_L3N_T0_DQS_34)
unnamed: R21.2, U1.N3 (IO_L3P_T0_DQS_34)
unnamed: R18.2, U1.P1 (IO_L4N_T0_34)
unnamed: R19.2, U1.N1 (IO_L4P_T0_34)
unnamed: R16.2, U1.P3 (IO_L5N_T0_34)
unnamed: R17.2, U1.P4 (IO_L5P_T0_34)
unnamed: R14.2, U1.N4 (IO_L6N_T0_VREF_34)
unnamed: R15.2, U1.M5 (IO_L6P_T0_34)
unnamed: R12.2, U1.R1 (IO_L7N_T1_34)
unnamed: R13.2, U1.R2 (IO_L7P_T1_34)
unnamed: R10.2, U1.T2 (IO_L8N_T1_34)
unnamed: R11.2, U1.R3 (IO_L8P_T1_34)
unnamed: R8.2, U1.T3 (IO_L9N_T1_DQS_34)
unnamed: R9.2, U1.T4 (IO_L9P_T1_DQS_34)
unnamed: R7.2, U1.P5 (IO_L10P_T1_34)
unnamed: U1.E8 (CCLK_0), U3.6 (CLK)
unnamed: R5.1, U1.K10 (INIT_B_0)
unnamed: R3.1, U1.M9 (M0_0)
P1_CLK: U1.E12 (IO_L13P_T2_MRCC_15); also elsewhere on the board
P1_IO0: U1.D13 (IO_L12P_T1_MRCC_15); also elsewhere on the board
P1_IO1: U1.C13 (IO_L12N_T1_MRCC_15); also elsewhere on the board
P1_IO2: U1.C11 (IO_L11P_T1_SRCC_15); also elsewhere on the board
P1_IO3: U1.C12 (IO_L11N_T1_SRCC_15); also elsewhere on the board
P1_IO4: U1.H14 (IO_L24P_T3_RS1_15); also elsewhere on the board
P1_IO5: U1.G15 (IO_L24N_T3_RS0_15); also elsewhere on the board
P1_IO6: U1.J15 (IO_L23P_T3_FOE_B_15); also elsewhere on the board
P1_IO7: U1.J16 (IO_L23N_T3_FWE_B_15); also elsewhere on the board
P1_NCS: U1.E11 (IO_L14P_T2_SRCC_15); also elsewhere on the board
P2_CLK: U1.E13 (IO_L13N_T2_MRCC_15); also elsewhere on the board
P2_IO0: U1.H16 (IO_L22P_T3_A17_15); also elsewhere on the board
P2_IO1: U1.G16 (IO_L22N_T3_A16_15); also elsewhere on the board
P2_IO2: U1.G14 (IO_L21P_T3_DQS_15); also elsewhere on the board
P2_IO3: U1.F14 (IO_L21N_T3_DQS_A18_15); also elsewhere on the board
P2_IO4: U1.H13 (IO_L20N_T3_A19_15); also elsewhere on the board
P2_IO5: U1.H12 (IO_L20P_T3_A20_15); also elsewhere on the board
P2_IO6: U1.G12 (IO_L19N_T3_A21_VREF_15); also elsewhere on the board
P2_IO7: U1.H11 (IO_L19P_T3_A22_15); also elsewhere on the board
P2_NCS: U1.D11 (IO_L14N_T2_SRCC_15); also elsewhere on the board
SPI1_MISO: U1.F15 (IO_L18P_T2_A24_15); also elsewhere on the board
SPI1_MOSI: U1.D16 (IO_L17N_T2_A25_15); also elsewhere on the board
SPI1_SCK: U1.E15 (IO_L18N_T2_A23_15); also elsewhere on the board

Notes on the sheet:
Vccbram
Vccaux
Vccint
Vcco

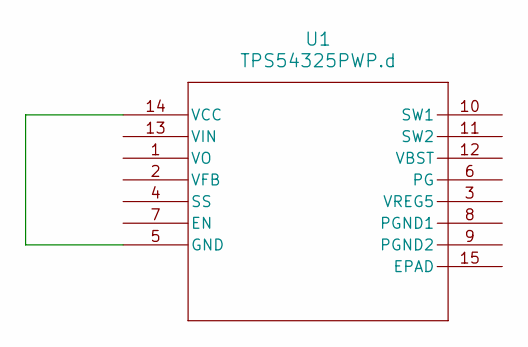
[picture p20: schematic hello-world.kicad_sch]

Parts:
U1: TPS54325PWP.d; PWP14_2P31X2P46

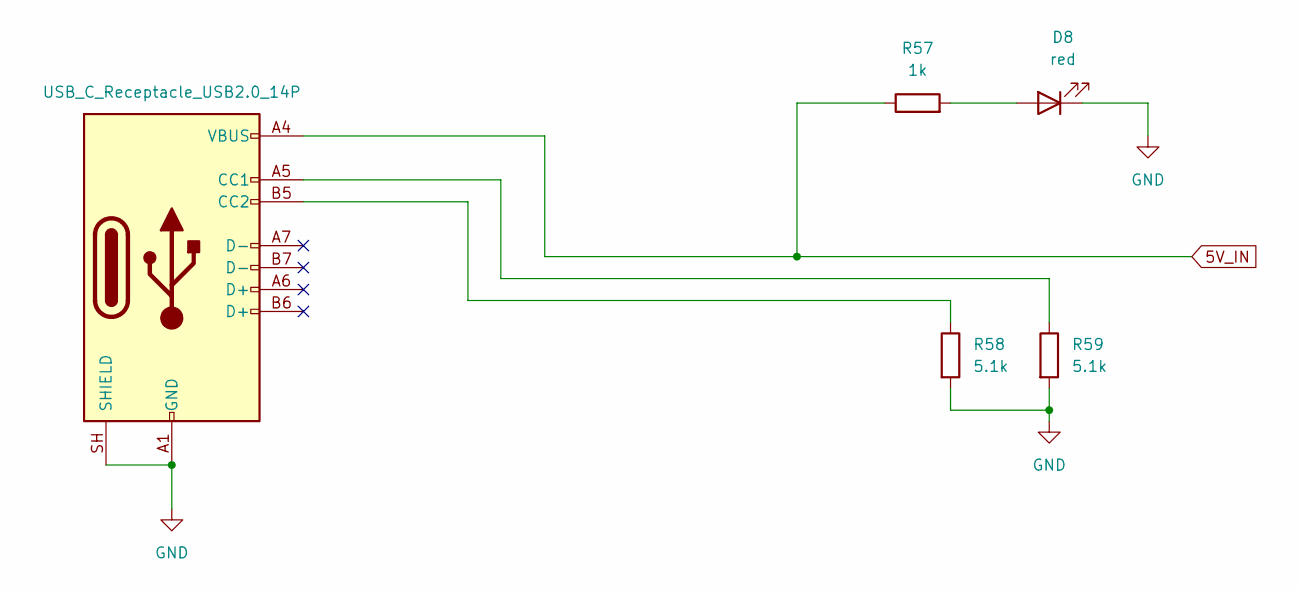
[picture p21: schematic power_source.kicad_sch]

Parts:
D8: red; LED_0805_2012Metric_Pad1.15x1.40mm_HandSolder
J7: USB_C_Receptacle_USB2.0_14P; USB_C_Receptacle_GCT_USB4105-xx-A_16P_TopMnt_Horizontal
R57: 1k; R_0805_2012Metric_Pad1.20x1.40mm_HandSolder
R58, R59: 5.1k; R_0805_2012Metric_Pad1.20x1.40mm_HandSolder

Connections:
5V_IN: J7.A4 (VBUS), J7.A9 (VBUS), J7.B4 (VBUS), J7.B9 (VBUS), R57.1; also elsewhere on the board
GND: D8.1 (K), J7.A1 (GND), J7.A12 (GND), J7.B1 (GND), J7.B12 (GND), J7.SH (SHIELD), R58.2, R59.2; also elsewhere on the board
unnamed: D8.2 (A), R57.2
unnamed: J7.A5 (CC1), R59.1
unnamed: J7.B5 (CC2), R58.1

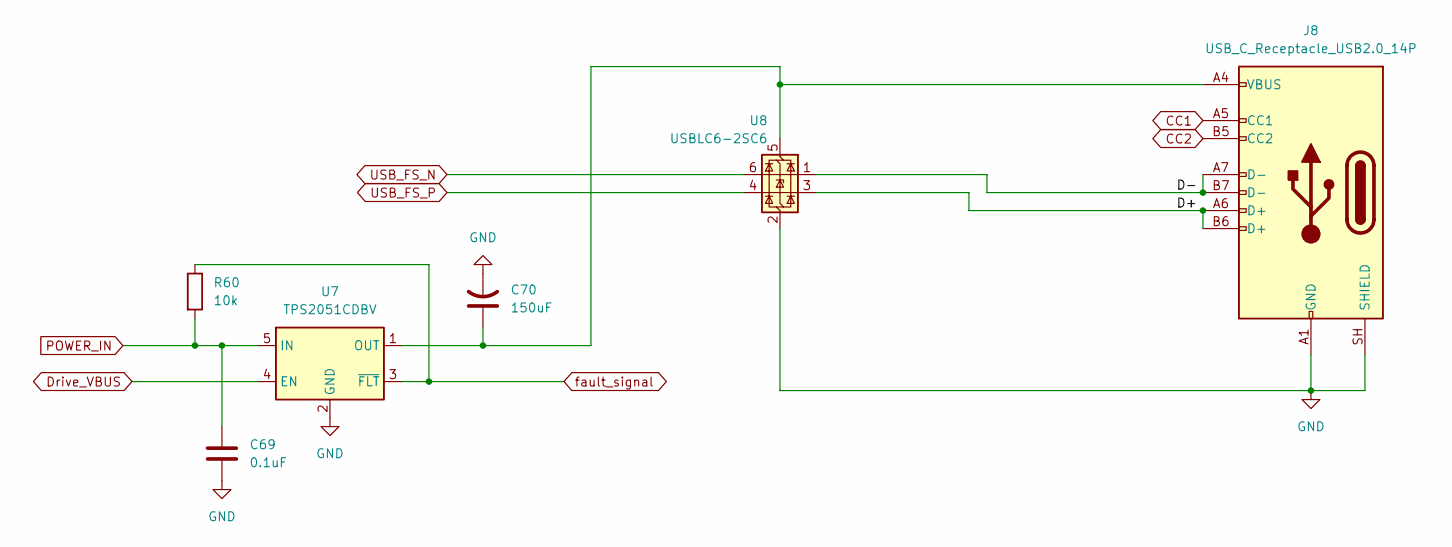
[picture p22: schematic usb_c.kicad_sch]

Parts:
C69: 0.1uF; C_0805_2012Metric_Pad1.18x1.45mm_HandSolder
C70: 150uF; C_0805_2012Metric_Pad1.18x1.45mm_HandSolder
J8: USB_C_Receptacle_USB2.0_14P; USB_C_Receptacle_GCT_USB4105-xx-A_16P_TopMnt_Horizontal
R60: 10k; R_0805_2012Metric_Pad1.20x1.40mm_HandSolder
U7: TPS2051CDBV; SOT-23-5
U8: USBLC6-2SC6; SOT-23-6

Connections:
/MCU/host_port/D+: J8.A6 (D+), J8.B6 (D+), U8.3 (I/O2)
/MCU/host_port/D-: J8.A7 (D-), J8.B7 (D-), U8.1 (I/O1)
CC1: J8.A5 (CC1); also elsewhere on the board
CC2: J8.B5 (CC2); also elsewhere on the board
Drive_VBUS: U7.4 (EN); also elsewhere on the board
GND: C69.2, C70.2, J8.A1 (GND), J8.A12 (GND), J8.B1 (GND), J8.B12 (GND), J8.SH (SHIELD), U7.2 (GND), U8.2 (GND); also elsewhere on the board
unnamed: C70.1, J8.A4 (VBUS), J8.A9 (VBUS), J8.B4 (VBUS), J8.B9 (VBUS), U7.1 (OUT), U8.5 (VBUS)
POWER_IN: C69.1, R60.2, U7.5 (IN); also elsewhere on the board
USB_FS_N: U8.6 (I/O1); also elsewhere on the board
USB_FS_P: U8.4 (I/O2); also elsewhere on the board
fault_signal: R60.1, U7.3 (~FLT); also elsewhere on the board
