fredrikr79/TDT4295-datamaskinprosjekt/pcb/tdt4295.kicad_pcb

## KiCad design pcb/tdt4295.kicad_pcb (continued)

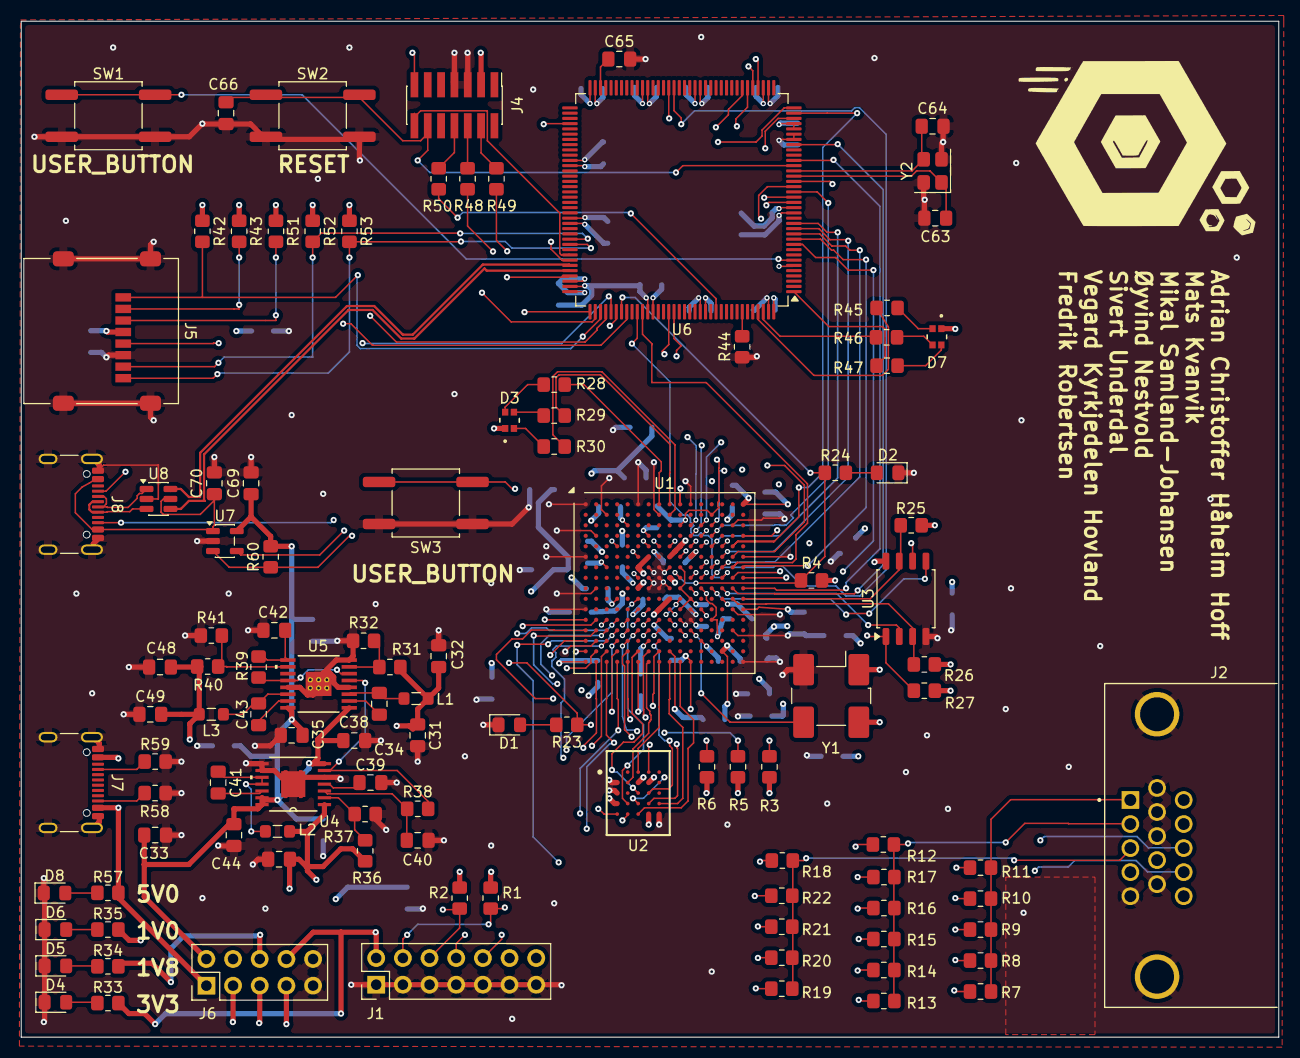
[picture p23: board tdt4295.kicad_pcb from above]

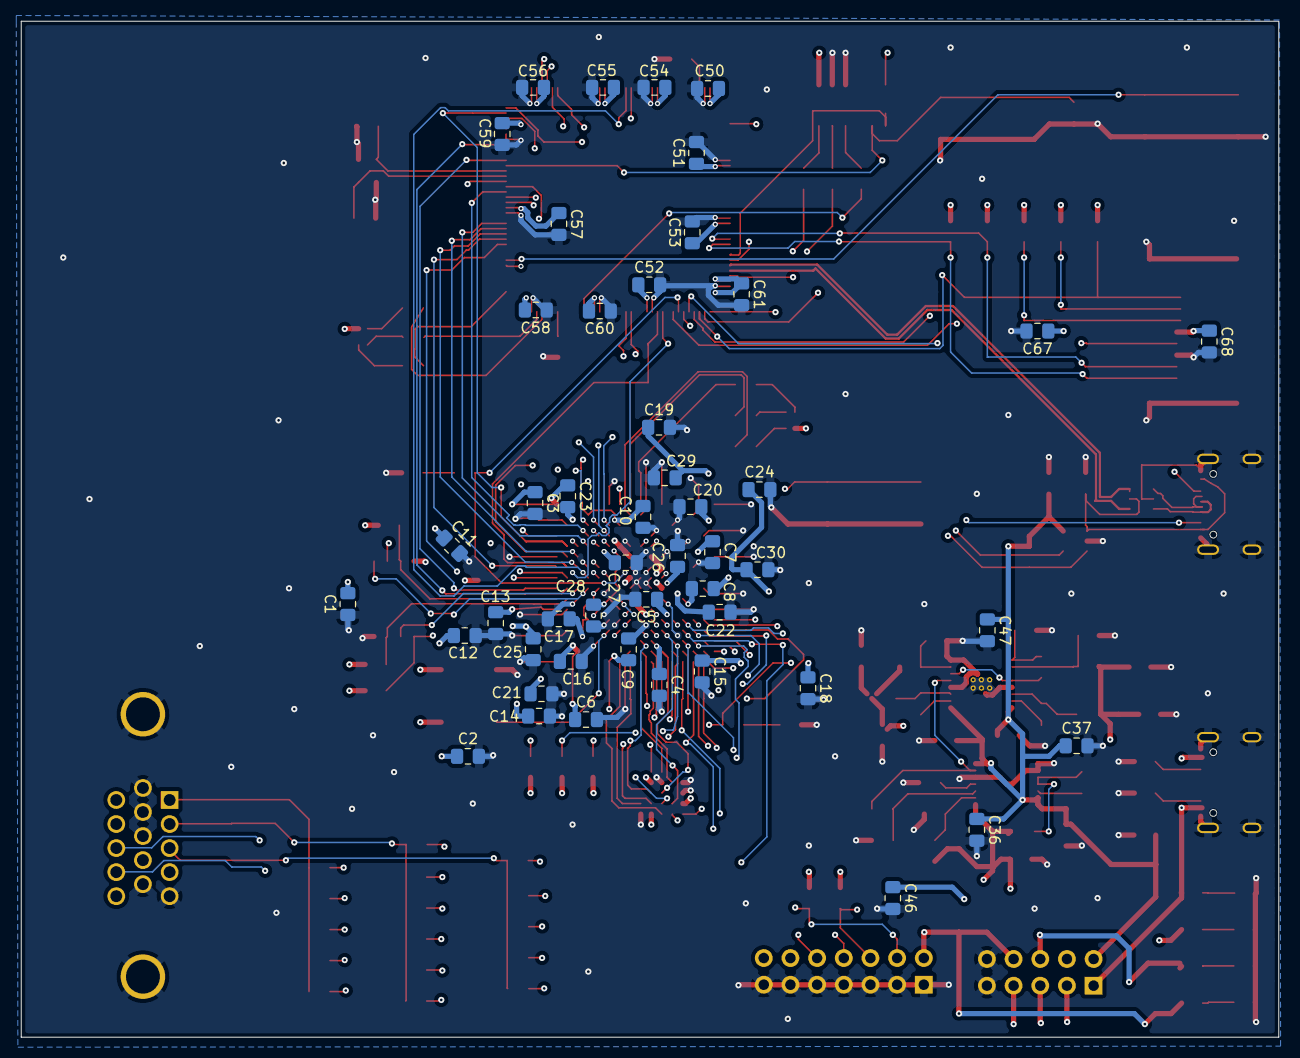
[picture p24: board tdt4295.kicad_pcb from below]

Board: 6 copper layers, 119.8 x 96.8 mm, 157 parts (48 on the bottom side), 144 nets.
