fredrikr79/TDT4295-datamaskinprosjekt/fpga/src/main.sv

module main #(
  parameter bit ON_BOARD_MEMORY = 1'b0
)(
    input wire clk_in,
    input wire user_btn,

    output wire [color_pkg::RedBits-1:0] vga_r,
    output wire [color_pkg::GreenBits-1:0] vga_g,
    output wire [color_pkg::BlueBits-1:0] vga_b,

    output wire vga_hsync,
    vga_vsync,


    // SPI Signals
    input wire ck_ss,
    ck_sck,
    ck_rst,

    inout wire [7:0] octo_spi,
//
    output wire led_r_n,
    led_g_n,
    led_b_n,
    ready,
    acknack,
    sync,

    // Memory signals
    output logic mem_clk,
    output logic mem_cs_n,
    output logic mem_reset_n,
    inout wire [7:0] mem_data_bus,
    inout wire mem_rwds
);


  wire mem_run_clock;
  wire clk;

  // Main onboard clock
  clk_wiz_0 clk_master (
    .clk_in(clk_in),
    .clk(clk)
  );

  logic ck_q = 1'b0;
  always_ff @(posedge clk) ck_q <= mem_run_clock ? ~ck_q : 1'b0;
  assign mem_clk = ck_q;
  logic active_area, pixel_pulse, v_blank, h_blank, frame_start, line_end, near_frame_end;

  vga_sync_params::x_coordinate_t coord_x;
  vga_sync_params::y_coordinate_t coord_y;
  color_pkg::color_t color;

  // Sync signal
  assign sync = frame_start;

  // Sim running
  logic sim_running; // Temporarily 1

  sim_pkg::row_buffer_t sim_window [3];
  sim_pkg::row_buffer_t sim_res_buffer [2];

  logic sim_mem_toggle;
  logic [31:0] sim_mem_addr;
  memory_pkg::message_length_t sim_mem_len;
  logic [7:0] sim_mem_in;
  memory_pkg::transaction_e sim_mem_transaction;

  // Row-commit handshake: sim_buffers -> fb_compositor
  logic sim_pulse_row_commit, sim_commit_res_buffer, sim_pulse_frame_restart;
  mem_map_pkg::fb_y_t sim_commit_y;


  // Memory signals
  logic spi_mem_toggle;
  logic [31:0] spi_mem_addr;
  memory_pkg::message_length_t spi_mem_len;
  logic [7:0] spi_mem_in, mem_out;
  memory_pkg::transaction_e spi_mem_transaction;

  localparam int unsigned NumLayers  = 2;
  localparam int unsigned LayerCells = 0;
  localparam int unsigned LayerHud   = 1;

  layer_pkg::layer_px_t layers[NumLayers];

  logic pulse_new_row, pulse_transaction_pair_done, pulse_row_done;
  sim_pkg::row_buffer_t buffers[3];
  sim_pkg::row_buffer_t res_buffers[2];

  logic fb_sel;
  logic fb_swap_pending;
  logic fb_frame_done;
  logic fb_frame_idle;
  logic fb_row_idle;
  logic fb_ready_for_frame;
  logic fb_underrun;
  logic fb_mem_toggle;
  memory_pkg::transaction_e fb_mem_transaction;
  memory_pkg::address_t fb_mem_address;
  memory_pkg::message_length_t fb_mem_length;

  // HUD sprites LUT declaration
  hud_pkg::sprite_inst_entry_t sprite_entry;
  hud_pkg::sprite_op_e sprite_req_op;
  wire sprite_req_valid, sprite_id_found, write_sprite_valid;
  wire [31:0] spi_write_sprite_base_addr;
  hud_pkg::sprite_mem_id sprite_mem_id;
  hud_pkg::sprite_inst_entry_t sprite_req_body;
  wire [hud_pkg::SpriteLutDepth-1:0] sprite_id_bitmap;
  hud_pkg::sprite_lut_id sprite_available_id;

  // Critical error detection (unrecoverable errors arising outside the SPI module)
  wire error_critical;
  assign error_critical = 1'b0;

  vga vga_controller (
      .clk(clk),
      .reset(~ck_rst),
      .enable(1'b1),
      .h_sync(vga_hsync),
      .v_sync(vga_vsync),
      .coord_x(coord_x),
      .coord_y(coord_y),
      .active_area(active_area),
      .pixel_pulse(pixel_pulse),
      .vga_r(vga_r),
      .vga_g(vga_g),
      .vga_b(vga_b),
      .color(color),
      .v_blank(v_blank),
      .h_blank(h_blank),
      .frame_start(frame_start),
      .near_frame_end(near_frame_end),
      .line_end(line_end)
  );


//   layer_pkg::layer_px_t cells_pixel_unused;
//   cells cell_controller (
//       .clk(clk),
//       .sw(sw),
//       .sim_running(sim_running),
//       .active_area(active_area),
//       .pixel_pulse(pixel_pulse),
//       .coord_x(coord_x),
//       .coord_y(coord_y),
//       .pixel(cells_pixel_unused) // Temporary for implementing frame buffer
//   );

  sim_buffers sim_line_memory_reader(
    .clk(clk),
    .reset(ck_rst),
    .sim_running(sim_running),

    .pulse_new_row(pulse_new_row),
    .buffers(sim_window),
    .pulse_transaction_pair_done(pulse_transaction_pair_done),
    .pulse_row_done(pulse_row_done),
    .res_buffer(sim_res_buffer),

    .fb_ready(fb_ready_for_frame),
    .fb_row_ready(fb_row_idle),

    .pulse_row_commit(sim_pulse_row_commit),
    .commit_y(sim_commit_y),
    .commit_res_buffer(sim_commit_res_buffer),
    .pulse_frame_restart(sim_pulse_frame_restart),

    .mem_toggle(sim_mem_toggle),
    .mem_transaction(sim_mem_transaction),
    .mem_address(sim_mem_addr),
    .mem_length(sim_mem_len),
    .mem_write_data(sim_mem_in),
    .mem_busy(mem_client_busy[memory_pkg::MemClientSimID]),
    .mem_data_on_cable(mem_client_data_on_cable[memory_pkg::MemClientSimID]),
    .mem_read_data(mem_out)
  );


  simulator sim_controller (
    .clk(clk),
    .pulse_new_row(pulse_new_row),
    .sim_running(sim_running),
    .input_buffers(sim_window),
    .pulse_transaction_pair_done(pulse_transaction_pair_done),
    .pulse_row_done(pulse_row_done),
    .output_buffers(sim_res_buffer)
  );

  // Swaps between fb0 and fb1, only when the compositor together with simulator has finished a frame.
  // If it has not, the scanout just renders the same fb again.
  logic v_blank_d1;
  logic v_blank_rising;
  assign v_blank_rising = v_blank && !v_blank_d1;

  always_ff @(posedge clk) begin
    if (ck_rst) begin
      fb_sel <= 1'b0;
      fb_swap_pending <= 1'b0;
      v_blank_d1 <= 1'b0;
    end else begin
      v_blank_d1 <= v_blank;
      if (fb_frame_done) fb_swap_pending <= 1'b1;
      if (v_blank_rising && fb_swap_pending) begin
        fb_sel <= ~fb_sel;
        fb_swap_pending <= 1'b0;
      end
    end
  end

  // The simulation may start simulating a frame only when the compositor is ready for it.
  assign fb_ready_for_frame = fb_frame_idle && !fb_swap_pending && !fb_frame_done;

  fb_scanout fb_display (
      .clk(clk),
      .reset(ck_rst),
      .active_area(active_area),
      .coord_x(coord_x),
      .coord_y(coord_y),
      .line_end(line_end),
      .near_frame_end(near_frame_end),
      .fb_sel(fb_sel),

      .mem_toggle(fb_mem_toggle),
      .mem_transaction(fb_mem_transaction),
      .mem_address(fb_mem_address),
      .mem_length(fb_mem_length),
      .mem_busy(mem_client_busy[memory_pkg::MemClientScanoutID]),
      .mem_data_on_cable(mem_client_data_on_cable[memory_pkg::MemClientScanoutID]),
      .mem_read_data(mem_out),

      .pixel(layers[LayerCells]),
      .underrun(fb_underrun)
  );
  // HUD
  assign layers[LayerHud] = layer_pkg::TransparentPixel;

  mem_map_pkg::fb_x_t fb_hud_x;
  mem_map_pkg::fb_y_t fb_hud_y;
  logic fb_hud_opaque;
  color_pkg::hud_color_t fb_hud_color;
  logic fb_hud_row_ready, fb_hud_overflow;
  logic fb_compositor_overrun;

  hud_pkg::sprite_mem_id hud_lookup_mem_id;
  logic [31:0] hud_lookup_mem_addr;

  logic hud_mem_toggle;
  memory_pkg::transaction_e hud_mem_transaction;
  memory_pkg::address_t hud_mem_address;
  memory_pkg::message_length_t hud_mem_length;

  // Rasterizes one row of sprite pixels ahead of the compositor writing it.
  hud_line_buffer hud_painter (
      .clk(clk),
      .reset(~ck_rst),

      .sprite_entry(sprite_entry),
      .lookup_mem_id(hud_lookup_mem_id),
      .lookup_mem_addr(hud_lookup_mem_addr),

      .pulse_frame_restart(sim_pulse_frame_restart),
      .pulse_row_commit(sim_pulse_row_commit),
      .commit_y(sim_commit_y),
      .row_ready(fb_hud_row_ready),

      .px_x(fb_hud_x),
      .px_opaque(fb_hud_opaque),
      .px_color(fb_hud_color),

      .mem_toggle(hud_mem_toggle),
      .mem_transaction(hud_mem_transaction),
      .mem_address(hud_mem_address),
      .mem_length(hud_mem_length),
      .mem_busy(mem_client_busy[memory_pkg::MemClientHudID]),
      .mem_data_on_cable(mem_client_data_on_cable[memory_pkg::MemClientHudID]),
      .mem_read_data(mem_out),

      // Currently not wired up against anything, but is a signal that is true on len(shortlist) > MaxActiveSprites
      .shortlist_overflow(fb_hud_overflow)
  );

  logic fb_wr_mem_toggle;
  memory_pkg::transaction_e fb_wr_mem_transaction;
  memory_pkg::address_t fb_wr_mem_address;
  memory_pkg::message_length_t fb_wr_mem_length;
  logic [7:0] fb_wr_mem_in;

  fb_compositor fb_writer (
      .clk(clk),
      .reset(ck_rst),

      .pulse_row_commit(sim_pulse_row_commit),
      .commit_y(sim_commit_y),
      .commit_res_buffer(sim_commit_res_buffer),
      .pulse_frame_restart(sim_pulse_frame_restart),
      .res_buffer(sim_res_buffer),

      .hud_x(fb_hud_x),
      .hud_y(fb_hud_y),
      .hud_opaque(fb_hud_opaque),
      .hud_color(fb_hud_color),
      .hud_row_ready(fb_hud_row_ready),

      .fb_sel(fb_sel),
      .frame_written(fb_frame_done),
      .frame_idle(fb_frame_idle),
      .row_idle(fb_row_idle),

      .mem_toggle(fb_wr_mem_toggle),
      .mem_transaction(fb_wr_mem_transaction),
      .mem_address(fb_wr_mem_address),
      .mem_length(fb_wr_mem_length),
      .mem_write_data(fb_wr_mem_in),
      .mem_busy(mem_client_busy[memory_pkg::MemClientCompositorID]),
      .mem_data_on_cable(mem_client_data_on_cable[memory_pkg::MemClientCompositorID]),

      .overrun(fb_compositor_overrun)
  );

  compositor #(
      .NumLayers(NumLayers)
  ) layer_compositor (
      .active_area(active_area),
      .layers(layers),
      .color(color)
  );

  hud hud_controller (
      .clk(clk),
      .req_valid(sprite_req_valid),
      .sprite_mem_id(sprite_mem_id),
      .sprite_w_mem_addr(spi_write_sprite_base_addr),
      .sprite_req_op(sprite_req_op),
      .sprite_req_body(sprite_req_body),
      .sprite_read_entry(sprite_entry),
      .sprite_id_bitmap(sprite_id_bitmap),
      .sprite_available_id(sprite_available_id),
      .sprite_id_found(sprite_id_found),
      .write_sprite_valid(write_sprite_valid),
      .lookup_mem_id(hud_lookup_mem_id),
      .lookup_mem_addr(hud_lookup_mem_addr)
  );

  // Controls who is allowed the external memory bus
  logic [memory_pkg::NumMemClients-1:0] mem_allow;
  mem_access_policy access_policy (
      .v_blank(v_blank),
      .near_frame_end(near_frame_end),
      .sim_running(sim_running),
      .allow(mem_allow)
  );

  logic [memory_pkg::NumMemClients-1:0] mem_client_toggle;
  memory_pkg::transaction_e mem_client_transaction[memory_pkg::NumMemClients];
  memory_pkg::address_t mem_client_address[memory_pkg::NumMemClients];
  memory_pkg::message_length_t mem_client_length_burst[memory_pkg::NumMemClients];
  logic [7:0] mem_client_write_data[memory_pkg::NumMemClients];
  logic [memory_pkg::NumMemClients-1:0] mem_client_busy;
  logic [memory_pkg::NumMemClients-1:0] mem_client_data_on_cable;
  logic [memory_pkg::NumMemClients-1:0] mem_client_grant; // Used by testbenches

  always_comb begin
    mem_client_toggle = '0;
    for (int unsigned i = 0; i < memory_pkg::NumMemClients; i++) begin
      mem_client_transaction[i] = memory_pkg::NONE;
      mem_client_address[i]     = '0;
      mem_client_length_burst[i]= '0;
      mem_client_write_data[i]  = '0;
    end

    // SPI
    mem_client_toggle[memory_pkg::MemClientSpiID]      = spi_mem_toggle;
    mem_client_transaction[memory_pkg::MemClientSpiID] = spi_mem_transaction;
    mem_client_address[memory_pkg::MemClientSpiID]     = spi_mem_addr;
    mem_client_length_burst[memory_pkg::MemClientSpiID]= spi_mem_len;
    mem_client_write_data[memory_pkg::MemClientSpiID]  = spi_mem_in;

    // Scan-out fb
    mem_client_toggle[memory_pkg::MemClientScanoutID]       = fb_mem_toggle;
    mem_client_transaction[memory_pkg::MemClientScanoutID]  = fb_mem_transaction;
    mem_client_address[memory_pkg::MemClientScanoutID]      = fb_mem_address;
    mem_client_length_burst[memory_pkg::MemClientScanoutID] = fb_mem_length;

    // Sim
    mem_client_toggle[memory_pkg::MemClientSimID]      = sim_mem_toggle;
    mem_client_transaction[memory_pkg::MemClientSimID] = sim_mem_transaction;
    mem_client_address[memory_pkg::MemClientSimID]     = sim_mem_addr;
    mem_client_length_burst[memory_pkg::MemClientSimID]= sim_mem_len;
    mem_client_write_data[memory_pkg::MemClientSimID]  = sim_mem_in;

    // HUD rasterizer
    mem_client_toggle[memory_pkg::MemClientHudID]      = hud_mem_toggle;
    mem_client_transaction[memory_pkg::MemClientHudID] = hud_mem_transaction;
    mem_client_address[memory_pkg::MemClientHudID]     = hud_mem_address;
    mem_client_length_burst[memory_pkg::MemClientHudID]= hud_mem_length;

    // Framebuffer compositor
    mem_client_toggle[memory_pkg::MemClientCompositorID]      = fb_wr_mem_toggle;
    mem_client_transaction[memory_pkg::MemClientCompositorID] = fb_wr_mem_transaction;
    mem_client_address[memory_pkg::MemClientCompositorID]     = fb_wr_mem_address;
    mem_client_length_burst[memory_pkg::MemClientCompositorID]= fb_wr_mem_length;
    mem_client_write_data[memory_pkg::MemClientCompositorID]  = fb_wr_mem_in;

    // TODO: Add the other clients here when they implement the external SRAM
  end

  spi spi_controller (
      .clk(clk),
      .ck_ss(ck_ss),
      .ck_sck(ck_sck),
      .ck_rst(ck_rst),
      .octo_spi(octo_spi),
      .acknack(acknack),
      .led_r_n(led_r_n),
      .led_g_n(led_g_n),
      .led_b_n(led_b_n),
      .ready(ready),

      .out_almost_empty(out_almost_empty),
      .out_empty(out_empty),
      .in_almost_full(in_almost_full),
      .in_full(in_full),

      // Sim running
      .sim_running(sim_running),

      // Memory module fall-through signals
      .mem_in(spi_mem_in),
      .mem_out(mem_out),
      .mem_len(spi_mem_len),
      .mem_addr(spi_mem_addr),
      .mem_transaction(spi_mem_transaction),
      .mem_busy(mem_client_busy[memory_pkg::MemClientSpiID]),
      .mem_allow(mem_allow[memory_pkg::MemClientSpiID]),
      .mem_data_on_wire(mem_client_data_on_cable[memory_pkg::MemClientSpiID]),
      .mem_toggle(spi_mem_toggle),

      // Sprite LUT transaction signals
      .sprite_available_id(sprite_available_id),
      .sprite_id_found(sprite_id_found),
      .sprite_id_bitmap(sprite_id_bitmap),
      .sprite_req_valid(sprite_req_valid),
      .sprite_req_body(sprite_req_body),
      .sprite_req_op(sprite_req_op),
      .write_sprite_valid(write_sprite_valid),
      .write_sprite_mem_id(sprite_mem_id),
      .write_sprite_base_addr(spi_write_sprite_base_addr),

      // Critical error line
      .error_critical(error_critical)
    );


  // simulator simulation_core (
  //   .clk(clk),
  //   .pulse_new_row(pulse_new_row),
  //   .sim_running(sim_running),
  //   .buffers(buffers),
  //   .pulse_transaction_pair_done(pulse_transaction_pair_done),
  //   .pulse_row_done(pulse_row_done),
  //   .res_buffer(res_buffers)
  // );

  if(ON_BOARD_MEMORY) begin : g_mem_onboard
    memory_onboard memory (
      .clk(clk),
      .reset(~ck_rst),
      .enable(1'b1),
      .transaction_toggle(mem_toggle),

      .next_transaction(mem_transaction),
      .address(mem_addr),
      .length(mem_len),
      .write_data(mem_in),

      // Info to FPGA
      .busy(mem_busy),
      .data_on_cable(mem_data_on_wire),
      .read_data(mem_out)
    );
  end else begin : g_mem

    memory memory (
      .clk(clk),
      .reset(~ck_rst),
      .enable(1'b1),
      .client_toggle(mem_client_toggle),
      .client_next_transaction(mem_client_transaction),
      .client_address(mem_client_address),
      .client_length(mem_client_length_burst),
      .client_write_data(mem_client_write_data),
      .client_allow(mem_allow),
      .client_busy(mem_busy),
      .client_data_on_cable(mem_data_on_wire),
      .client_grant(mem_client_grant),
      .read_data(mem_out),
      // Actual memory pins
      .run_clock(mem_run_clock),
      .cs_n(mem_cs_n),
      .reset_n(mem_reset_n),
      .dq(mem_data_bus),
      .rwds(mem_rwds)
    );
  end

endmodule
