fredrikr79/TDT4295-datamaskinprosjekt/fpga/src/memory/memory_controller.sv

module memory_controller (

    // input from fpga
    input logic clk,
    input logic reset,
    input logic enable,
    input logic transaction_toggle,

    input memory_pkg::transaction_e next_transaction,
    input memory_pkg::address_t address,
    input memory_pkg::message_length_t length,
    input logic [7:0] write_data,

    // Info to fpga
    output logic busy,
    data_on_cable,
    output logic [7:0] read_data,
    output logic run_clock,

    // Memory pins
    output logic cs_n,
    output logic reset_n,
    inout wire [7:0] dq,
    inout wire rwds
);
  logic                        [7:0] dq_in;
  logic                        [7:0] dq_out;
  logic                              rwds_in;
  logic                              rwds_out;

  logic                              dq_oe;
  logic                              rwds_oe;

  logic                              double_latency;
  logic                              current_transaction_toggle;
  memory_pkg::address_t              current_address;
  memory_pkg::message_length_t       current_length;
  memory_pkg::transaction_e          current_transaction;


  assign dq_in   = dq;
  assign rwds_in = rwds;

  assign dq      = dq_oe ? dq_out : 8'bzzzzzzzz;
  assign rwds    = rwds_oe ? rwds_out : 1'bz;

  assign reset_n = ~reset;

  memory_pkg::state_e current_state, previous_state;
  assign busy = current_state != memory_pkg::IDLE;

  // Ensure samplig happens @ negedge
  logic [7:0] delayed_dq;
  always @(posedge clk) delayed_dq <= dq_in;
  always @(negedge clk) read_data <= delayed_dq;

  // Keep track of clk where reading occured
  logic [7:0] read_alignment_buff = '0;
  always @(negedge clk) read_alignment_buff
    <= {read_alignment_buff[6:0], current_state == memory_pkg::READING};

  // Delay reads by ReadDataDelay cycles.
  // This way data_on_cable is only issued when the data is actually present.
  assign data_on_cable =
    read_alignment_buff[memory_pkg::ReadDataDelay - 1] ||
    current_state == memory_pkg::WRITING;

  always_comb begin
    case (current_state)
      memory_pkg::IDLE: begin
        dq_oe = 0;
        rwds_oe = 0;
        cs_n = 1;
        run_clock = 0;
      end
      memory_pkg::STARTING_TRANSACTION: begin
        dq_oe = 0;
        rwds_oe = 0;
        cs_n = 1;
        run_clock = 0;
      end
      memory_pkg::SENDING_CMD: begin
        dq_oe = 1;
        rwds_oe = 0;
        cs_n = 0;
        run_clock = 1;
      end
      memory_pkg::SENDING_ADDRESS: begin
        dq_oe = 1;
        rwds_oe = 0;
        cs_n = 0;
        run_clock = 1;
      end
      memory_pkg::WAITING_ON_LATENCY: begin
        dq_oe = 0;
        rwds_oe = 0;
        cs_n = 0;
        run_clock = 1;
      end
      memory_pkg::READING: begin
        dq_oe = 0;
        rwds_oe = 0;
        cs_n = 0;
        run_clock = 1;
      end
      memory_pkg::WRITING: begin
        dq_oe = 1;
        rwds_oe = current_transaction == memory_pkg::WRITE;
        cs_n = 0;
        run_clock = 1;
      end
      memory_pkg::READ_TAIL: begin
        // Ensure delayed read is closed before ending transaction
        dq_oe = 0;
        rwds_oe = 0;
        cs_n = 0;
        run_clock = 0;
      end
      default: begin
        dq_oe = 0;
        rwds_oe = 0;
        cs_n = 1;
        run_clock = 0;
      end
    endcase
  end

  logic reset_byte_counter;
  assign reset_byte_counter = (current_state == previous_state) ? 0 : 1;
  localparam int unsigned ByteCounterWidth = (memory_pkg::MaxMessageLength > 1)
      ? $clog2(memory_pkg::MaxMessageLength) : 1;

  logic [ByteCounterWidth-1:0] bytes_this_state_raw;
  memory_pkg::message_length_t bytes_this_state;
  assign bytes_this_state = memory_pkg::message_length_t'(bytes_this_state_raw);

  mod_n_counter #(
      .N(memory_pkg::MaxMessageLength)
  ) byte_counter (
      .clk(clk),
      .enable(enable),
      .reset(reset_byte_counter | reset),
      .count(bytes_this_state_raw)
  );

  function automatic void update_outputs(input memory_pkg::transaction_output_t transaction_out);
    previous_state <= current_state;
    current_state <= transaction_out.next_state;
    dq_out <= transaction_out.dq;
    rwds_out <= transaction_out.rwds;
  endfunction

  always_ff @(posedge clk) begin
    if (reset) begin
      current_transaction <= memory_pkg::NONE;
      current_transaction_toggle <= transaction_toggle;
    end else if (enable && current_state == memory_pkg::IDLE) begin
      if (transaction_toggle != current_transaction_toggle) begin
        current_transaction <= next_transaction;
        current_address <= address;
        current_length <= length;
        current_transaction_toggle <= transaction_toggle;
      end else begin
        current_transaction <= memory_pkg::NONE;
      end
    end
  end

  memory_pkg::transaction_output_t none_out = '{
      rwds: 'b0,
      dq: 'h00,
      next_state: memory_pkg::IDLE,
      read_data: 'h00
  };
  memory_pkg::transaction_output_t reset_enable_out;
  mem_txn_reset_enable reset_enable_transaction (
      .reset(reset),
      .enable(enable),
      .rwds_in(rwds_in),
      .current_state(current_state),
      .bytes_this_state(bytes_this_state),
      .out(reset_enable_out)
  );
  memory_pkg::transaction_output_t reset_txn_out;
  mem_txn_reset reset_transaction (
      .reset(reset),
      .enable(enable),
      .current_state(current_state),
      .bytes_this_state(bytes_this_state),
      .out(reset_txn_out)
  );
  memory_pkg::transaction_output_t deep_power_down_txn_out;
  mem_txn_deep_power_down deep_power_down_transaction (
      .reset(reset),
      .enable(enable),
      .current_state(current_state),
      .bytes_this_state(bytes_this_state),
      .out(deep_power_down_txn_out)
  );
  memory_pkg::transaction_output_t deep_power_up_txn_out;
  mem_txn_deep_power_up deep_power_up_transaction (
      .reset(reset),
      .enable(enable),
      .current_state(current_state),
      .out(deep_power_up_txn_out)
  );
  memory_pkg::transaction_output_t write_enable_txn_out;
  mem_txn_write_enable write_enable_transaction (
      .reset(reset),
      .enable(enable),
      .current_state(current_state),
      .bytes_this_state(bytes_this_state),
      .out(write_enable_txn_out)
  );
  memory_pkg::transaction_output_t write_disable_txn_out;
  mem_txn_write_disable write_disable_transaction (
      .reset(reset),
      .enable(enable),
      .current_state(current_state),
      .bytes_this_state(bytes_this_state),
      .out(write_disable_txn_out)
  );
  memory_pkg::transaction_output_t write_any_register_txn_out;
  mem_txn_write_any_register write_any_register_transaction (
      .reset(reset),
      .enable(enable),
      .address(current_address),
      .write_data,
      .current_state(current_state),
      .bytes_this_state(bytes_this_state),
      .out(write_any_register_txn_out)
  );
  memory_pkg::transaction_output_t read_any_register_txn_out;
  mem_txn_read_any_register read_any_register_transaction (
      .reset(reset),
      .enable(enable),
      .dq_in(dq_in),
      .address(current_address),
      .double_latency,
      .current_state(current_state),
      .bytes_this_state(bytes_this_state),
      .out(read_any_register_txn_out)
  );
  memory_pkg::transaction_output_t read_id_txn_out;
  mem_txn_read_id read_id_transaction (
      .reset(reset),
      .enable(enable),
      .dq_in(dq_in),
      .double_latency,
      .current_state(current_state),
      .bytes_this_state(bytes_this_state),
      .out(read_id_txn_out)
  );
  memory_pkg::transaction_output_t read_txn_out;
  mem_txn_read read_transaction (
      .reset(reset),
      .enable(enable),
      .dq_in(dq_in),
      .address(current_address),
      .read_length(current_length),
      .double_latency,
      .current_state(current_state),
      .bytes_this_state(bytes_this_state),
      .out(read_txn_out)
  );
  memory_pkg::transaction_output_t write_txn_out;
  mem_txn_write write_transaction (
      .reset(reset),
      .enable(enable),
      .dq_in(dq_in),
      .address(current_address),
      .write_length(current_length),
      .double_latency,
      .write_data,
      .current_state(current_state),
      .bytes_this_state(bytes_this_state),
      .out(write_txn_out)
  );

  // Drive Read_tail state until done or transition into it if READING, heading into IDLE
  memory_pkg::transaction_output_t txn_data_out;
  always_comb begin
    txn_data_out = find_transaction_output(current_transaction);
    if (current_state == memory_pkg::READ_TAIL) begin
      txn_data_out = none_out;
      txn_data_out.next_state = (
        bytes_this_state == memory_pkg::message_length_t'(memory_pkg::ReadDataDelay - 1)
      )
      ? memory_pkg::IDLE
      : memory_pkg::READ_TAIL;
    end else if(
      current_state == memory_pkg::READING &&
      txn_data_out.next_state == memory_pkg::IDLE
    ) begin
        txn_data_out.next_state = memory_pkg::READ_TAIL;
    end
  end

  always @(negedge clk) begin
    if (reset) begin
      update_outputs(find_transaction_output(memory_pkg::NONE));
    end else if (enable) begin
      update_outputs(txn_data_out);
      if (current_state == memory_pkg::SENDING_CMD || current_state == memory_pkg::SENDING_ADDRESS)
        double_latency <= rwds_in;
    end
  end

  function automatic memory_pkg::transaction_output_t find_transaction_output(
      input memory_pkg::transaction_e transaction);
    case (transaction)
      memory_pkg::RESET_ENABLE: return reset_enable_out;
      memory_pkg::RESET: return reset_txn_out;
      memory_pkg::DEEP_POWER_DOWN: return deep_power_down_txn_out;
      memory_pkg::DEEP_POWER_UP: return deep_power_up_txn_out;
      memory_pkg::WRITE_ENABLE: return write_enable_txn_out;
      memory_pkg::WRITE_DISABLE: return write_disable_txn_out;
      memory_pkg::WRITE_ANY_REGISTER: return write_any_register_txn_out;
      memory_pkg::READ_ANY_REGISTER: return read_any_register_txn_out;
      memory_pkg::READ_ID: return read_id_txn_out;
      memory_pkg::READ: return read_txn_out;
      memory_pkg::WRITE: return write_txn_out;
      default: return none_out;
    endcase
  endfunction


endmodule
