fredrikr79/TDT4295-datamaskinprosjekt/mcu/hexMCU/src/port/host/storage_host.c

/* storage_host.c - storage.h on the PC: files under a local folder laid
 * out like the SD card (rom/, save/, ...).
 *
 * The folder: $HEXMCU_SD if set, else STORAGE_HOST_ROOT (default "sd",
 * relative to where the program runs). Give CMake an absolute one, e.g.
 *   target_compile_definitions(hexmcu_host PRIVATE
 *       STORAGE_HOST_ROOT="${CMAKE_CURRENT_SOURCE_DIR}/sd")
 * No folder behaves like no card -- handy for testing that path. */

#define LOG_TAG "sd"

#include <errno.h>
#include <stdio.h>
#include <stdlib.h>
#include <string.h>
#include <sys/stat.h>
#ifndef _MSC_VER
#include <dirent.h>          /* MinGW has it too; MSVC doesn't: no "sd ls" there */
#endif
#ifndef _WIN32
#include <sys/statvfs.h>
#endif

#ifdef _WIN32
#include <direct.h>
#define make_dir(p)   _mkdir(p)
#define remove_dir(p) _rmdir(p)
#else
#include <unistd.h>
#define make_dir(p)   mkdir((p), 0777)
#define remove_dir(p) rmdir(p)
#endif

#include "storage.h"
#include "log.h"
#include "platform.h"

#ifndef STORAGE_HOST_ROOT
#define STORAGE_HOST_ROOT "sd"
#endif

#define PATH_MAX_LEN 512

static bool     mounted;
static char     note[160] = "not tried yet";    /* storage_info(): the last thing that happened */
static bool     tried;
static uint32_t last_try;

static const char *root_dir(void)
{
    const char *env = getenv("HEXMCU_SD");
    return env && *env ? env : STORAGE_HOST_ROOT;
}

static storage_status_t mount(void)
{
    if (mounted) return STORAGE_OK;
    if (tried && plat_millis() - last_try < STORAGE_RETRY_MS) return STORAGE_NO_CARD;
    tried    = true;
    last_try = plat_millis();

    struct stat st;
    if (stat(root_dir(), &st) != 0 || !S_ISDIR(st.st_mode)) {
        LOG_WARN("no card: folder '%s' not found", root_dir());
        snprintf(note, sizeof note, "no card: folder '%s' not found", root_dir());
        return STORAGE_NO_CARD;
    }
    LOG_INFO("card: folder '%s'", root_dir());
    snprintf(note, sizeof note, "mounted: folder '%s'", root_dir());
    mounted = true;
    return STORAGE_OK;
}

/* root + "/" + path; refuses ".." so nothing outside the folder is touched */
static bool full_path(const char *path, char *out)
{
    if (!path || !*path || strstr(path, "..")) return false;
    int n = snprintf(out, PATH_MAX_LEN, "%s/%s", root_dir(), path);
    return n > 0 && n < PATH_MAX_LEN;
}

static storage_status_t from_errno(int e)
{
    switch (e) {
    case ENOENT: return STORAGE_NOT_FOUND;
    case ENOSPC: return STORAGE_FULL;
    default:     return STORAGE_ERROR;
    }
}

storage_status_t storage_init(void) { return mount(); }
bool storage_ready(void)            { return mounted; }

storage_status_t storage_read(const char *path, uint32_t offset, void *buf,
                              uint32_t max, uint32_t *got)
{
    char fp[PATH_MAX_LEN];
    *got = 0;
    storage_status_t st = mount();
    if (st != STORAGE_OK) return st;
    if (!full_path(path, fp)) return STORAGE_ERROR;

    FILE *f = fopen(fp, "rb");
    if (!f) return from_errno(errno);
    if (fseek(f, (long)offset, SEEK_SET) != 0) { fclose(f); return STORAGE_ERROR; }
    size_t n = fread(buf, 1, max, f);
    bool bad = ferror(f) != 0;
    fclose(f);
    if (bad) return STORAGE_ERROR;
    *got = (uint32_t)n;
    return STORAGE_OK;
}

storage_status_t storage_size(const char *path, uint32_t *size)
{
    char fp[PATH_MAX_LEN];
    *size = 0;
    storage_status_t st = mount();
    if (st != STORAGE_OK) return st;
    if (!full_path(path, fp)) return STORAGE_ERROR;

    struct stat s;
    if (stat(fp, &s) != 0) return from_errno(errno);
    if (!S_ISREG(s.st_mode)) return STORAGE_NOT_FOUND;
    *size = (uint32_t)s.st_size;
    return STORAGE_OK;
}

/* make every folder on the way to the file */
static void make_parents(char *fp)
{
    size_t skip = strlen(root_dir()) + 1;           /* the root exists */
    for (char *p = fp + skip; *p; p++) {
        if (*p != '/') continue;
        *p = '\0';
        make_dir(fp);                               /* EEXIST is fine */
        *p = '/';
    }
}

/* append: add to the end (file made if missing); else replace the file */
static storage_status_t write_file(const char *path, const void *data, uint32_t len,
                                   bool append)
{
    char fp[PATH_MAX_LEN];
    storage_status_t st = mount();
    if (st != STORAGE_OK) return st;
    if (!full_path(path, fp)) return STORAGE_ERROR;
    if (len && !data) return STORAGE_ERROR;

    make_parents(fp);
    FILE *f = fopen(fp, append ? "ab" : "wb");
    if (!f) return from_errno(errno);
    size_t n = len ? fwrite(data, 1, len, f) : 0;
    int e = errno;
    if (fclose(f) != 0 || n != len) {
        LOG_ERR("write %s: %s", path, strerror(e));
        return from_errno(e);
    }
    return STORAGE_OK;
}

storage_status_t storage_write(const char *path, const void *data, uint32_t len)
{
    return write_file(path, data, len, false);
}

storage_status_t storage_append(const char *path, const void *data, uint32_t len)
{
    return write_file(path, data, len, true);
}

storage_status_t storage_delete(const char *path)
{
    char fp[PATH_MAX_LEN];
    storage_status_t st = mount();
    if (st != STORAGE_OK) return st;
    if (!full_path(path, fp)) return STORAGE_ERROR;
    return remove(fp) == 0 ? STORAGE_OK : from_errno(errno);
}

#ifndef _MSC_VER
/* Everything in folder fp (a full path), then the folder itself. */
static storage_status_t delete_tree(const char *fp, unsigned depth, uint32_t *files)
{
    DIR *d = opendir(fp);
    if (!d) return from_errno(errno);
    struct dirent *e;
    storage_status_t st = STORAGE_OK;
    while (st == STORAGE_OK && (e = readdir(d)) != NULL) {
        if (!strcmp(e->d_name, ".") || !strcmp(e->d_name, "..")) continue;
        char cp[PATH_MAX_LEN];
        struct stat s;
        int n = snprintf(cp, sizeof cp, "%s/%s", fp, e->d_name);
        if (n <= 0 || (size_t)n >= sizeof cp || stat(cp, &s) != 0) { st = STORAGE_ERROR; break; }
        if (S_ISDIR(s.st_mode)) {
            st = depth >= STORAGE_DELETE_DEPTH ? STORAGE_ERROR
                                               : delete_tree(cp, depth + 1u, files);
        } else if (remove(cp) == 0) {
            if (files) (*files)++;
        } else {
            st = from_errno(errno);
        }
    }
    closedir(d);
    if (st != STORAGE_OK) return st;
    return remove_dir(fp) == 0 ? STORAGE_OK : from_errno(errno);
}
#endif

storage_status_t storage_delete_dir(const char *dir, uint32_t *files)
{
    char fp[PATH_MAX_LEN], rel[PATH_MAX_LEN];
    if (files) *files = 0;
    storage_status_t st = mount();
    if (st != STORAGE_OK) return st;
    while (dir && *dir == '/') dir++;               /* "/save" = "save"      */
    if (!dir || !*dir) return STORAGE_ERROR;        /* never the whole card  */
    int n = snprintf(rel, sizeof rel, "%s", dir);
    if (n <= 0 || (size_t)n >= sizeof rel) return STORAGE_ERROR;
    while (n && rel[n - 1] == '/') rel[--n] = '\0'; /* "save/" = "save"     */
    if (!n || !full_path(rel, fp)) return STORAGE_ERROR;

    struct stat s;
    if (stat(fp, &s) != 0) return from_errno(errno);
    if (!S_ISDIR(s.st_mode)) return STORAGE_ERROR;
#ifdef _MSC_VER
    return STORAGE_ERROR;                           /* no dirent.h there */
#else
    return delete_tree(fp, 1u, files);
#endif
}

storage_status_t storage_rename(const char *from, const char *to)
{
    char fp[PATH_MAX_LEN], tp[PATH_MAX_LEN];
    storage_status_t st = mount();
    if (st != STORAGE_OK) return st;
    if (!full_path(from, fp) || !full_path(to, tp)) return STORAGE_ERROR;
    make_parents(tp);
#ifdef _WIN32
    remove(tp);                                     /* rename() won't replace there */
#endif
    return rename(fp, tp) == 0 ? STORAGE_OK : from_errno(errno);
}

storage_status_t storage_info(storage_info_t *info)
{
    memset(info, 0, sizeof *info);
    tried = false;                  /* asked for: try now, not after the retry wait */
    info->where = root_dir();
    storage_status_t s = mount();
    info->mounted = mounted;
    info->note    = note;
    if (s != STORAGE_OK) return s;
#ifndef _WIN32
    struct statvfs v;
    if (statvfs(root_dir(), &v) == 0) {
        info->total = (uint64_t)v.f_blocks * v.f_frsize;
        info->free  = (uint64_t)v.f_bavail * v.f_frsize;
    }
#endif
    return STORAGE_OK;
}

storage_status_t storage_list(const char *dir, storage_list_fn fn, void *ctx)
{
    char fp[PATH_MAX_LEN], ep[PATH_MAX_LEN];
    storage_status_t s = mount();
    if (s != STORAGE_OK) return s;
    if (!dir) dir = "";
    while (*dir == '/') dir++;                      /* "/" = "" = the root */
    if (*dir) { if (!full_path(dir, fp)) return STORAGE_ERROR; }
    else snprintf(fp, sizeof fp, "%s", root_dir());

#ifdef _MSC_VER
    (void)fn; (void)ctx;
    return STORAGE_ERROR;
#else
    DIR *d = opendir(fp);
    if (!d) return from_errno(errno);
    struct dirent *e;
    while ((e = readdir(d)) != NULL) {
        if (!strcmp(e->d_name, ".") || !strcmp(e->d_name, "..")) continue;
        struct stat st;
        int n = snprintf(ep, sizeof ep, "%s/%s", fp, e->d_name);
        bool ok = n > 0 && (size_t)n < sizeof ep && stat(ep, &st) == 0;
        fn(ctx, e->d_name, ok ? (uint32_t)st.st_size : 0u, ok && S_ISDIR(st.st_mode));
    }
    closedir(d);
    return STORAGE_OK;
#endif
}

const char *storage_status_str(storage_status_t st)
{
    static const char *const names[] =
        { "ok", "no card", "file not found", "card full", "storage error" };
    return (unsigned)st < sizeof names / sizeof names[0] ? names[st] : "?";
}
