fredrikr79/TDT4295-datamaskinprosjekt/mcu/hexMCU/src/app/probe.c

/* ======================================================================
 * probe.c - the handshake with the FPGA (see probe.h).
 *
 *   WAIT --(READY steady, retry time reached)--> ECHO --ok--> INFO --ok--> DONE
 *    ^  |                                         |             |
 *    |  +- READY not steady within 100 ms -+      |             |
 *    +------------------ failed -----------+------+-------------+
 *
 * Every wait has a timeout, and each one that runs out is a failed try:
 * counted, and shown on the status line ("probing FPGA: x7 (...)"). The
 * first failure of a series is also logged once, with its reason.
 *
 * Why wait for READY first: before the first byte of the ECHO goes out,
 * READY must have been high, with no stray edges, for READY_QUIET_MS.
 * Otherwise an FPGA still booting (or a noisy line) could catch the
 * command halfway through and take some byte in the middle as the opcode.
 * Edges taken by commands (fpga_ready_used()) don't count, only stray
 * ones. Two stray edges less than READY_QUIET_MS apart is a READY storm:
 * logged once when it starts and once when it ends, and shown on the
 * status line. Normal commands don't wait for this (fpga.c only checks
 * that READY is high before each transfer).
 * ====================================================================== */
#define LOG_TAG "probe"

#include <stdint.h>
#include <stdbool.h>
#include <stdio.h>

#include "probe.h"
#include "fpga.h"
#include "transport.h"
#include "platform.h"
#include "log.h"
#include "cli.h"
#include "led.h"

#define PROBE_LEN         100u  /* ECHO bytes                                 */
#define PROBE_RETRY_MS    200u  /* between tries                              */
#define READY_QUIET_MS    10u   /* READY high and no stray edges this long    */
#define STATUS_EVERY_MS   100u  /* status line redrawn at most this often     */
#define READY_WAIT_MS     100u  /* READY not steady this long: a failed try   */

typedef enum { P_WAIT, P_ECHO, P_INFO, P_INFO_WAIT, P_DONE, P_STOPPED } phase_t;

static struct {
    phase_t    ph;              /* starts as P_WAIT                       */
    uint32_t   retry_at;        /* P_WAIT: don't send before this         */
    bool       retry_wait;      /* retry_at is in use                     */
    bool       ready_wait;      /* waiting for a steady READY, since ...  */
    uint32_t   ready_from;      /* ... this                               */
    uint32_t   tries;           /* failed tries in a row                  */
    fpga_err_t err;             /* why the last one failed                */
    const char *what;           /* "probe" or "INFO": which one failed    */
    uint8_t    pattern;         /* changes every try                      */
} p;

static uint8_t probe_tx[PROBE_LEN], probe_rx[PROBE_LEN];

/* ---- READY: steady before we send ----------------------------------- */
static struct {
    bool     init;              /* the fields below are set up           */
    uint32_t spare;             /* stray edges counted so far            */
    uint32_t edge_at;           /* when a stray edge was last seen       */
    uint32_t low_at;            /* when READY was last seen low          */
    bool     storm;
    uint32_t storm_edges, storm_from;
} rdy;

static uint32_t stray_ready_count(void)
{
    return transport_ready_count() - fpga_ready_used();
}

/* true: READY has been high, with no stray edges, for READY_QUIET_MS. */
static bool ready_quiet(uint32_t now)
{
    uint32_t c = stray_ready_count();
    bool high = plat_fpga_ready_pin();
    if (!rdy.init) {                    /* watch it for READY_QUIET_MS first */
        rdy.init = true;
        rdy.spare = c;
        rdy.edge_at = rdy.low_at = now;
    }
    if (c != rdy.spare) {
        uint32_t n = c - rdy.spare;
        rdy.spare = c;
        if (n > 1 || now - rdy.edge_at < READY_QUIET_MS) {
            if (!rdy.storm) {
                rdy.storm = true;
                rdy.storm_edges = 0;
                rdy.storm_from = now;
                LOG_WARN("READY storm (edges < %u ms apart): waiting for it to stop",
                         READY_QUIET_MS);
                led_set(LED_READY_STORM, true);
            }
            rdy.storm_edges += n;
        }
        rdy.edge_at = now;
    }
    if (!high) rdy.low_at = now;

    bool quiet = high && now - rdy.edge_at >= READY_QUIET_MS && now - rdy.low_at >= READY_QUIET_MS;
    if (quiet && rdy.storm) {
        rdy.storm = false;
        led_set(LED_READY_STORM, false);
        LOG_INFO("READY storm over: %lu edges in %lu ms", (unsigned long)rdy.storm_edges,
                 (unsigned long)(rdy.edge_at - rdy.storm_from));
    }
    return quiet;
}

/* ---- the status line in front of the console prompt ------------------- */
static void show_status(uint32_t now, bool at_once)
{
    static uint32_t shown_at;
    if (!at_once && now - shown_at < STATUS_EVERY_MS) return;
    shown_at = now;

    char msg[64];
    if (rdy.storm)
        snprintf(msg, sizeof msg, "READY storm: %lu edges, waiting", (unsigned long)rdy.storm_edges);
    else if (p.tries && p.err == FPGA_ERR_NOT_READY)
        snprintf(msg, sizeof msg, "probing FPGA: x%lu (READY not high and steady)",
                 (unsigned long)p.tries);
    else if (p.tries)
        snprintf(msg, sizeof msg, "probing FPGA: x%lu (%s: %s)", (unsigned long)p.tries,
                 p.what, fpga_err_str(p.err));
    else
        msg[0] = '\0';
    cli_status(msg);
}

/* ---- the commands ---------------------------------------------------- */
/* A try failed: count it, wait retry_ms, then start again from the READY
 * check. Only the first failure of a series goes to the log. */
static void try_failed(const char *what, fpga_err_t err, uint32_t retry_ms)
{
    if (p.tries == 0 && err == FPGA_ERR_NOT_READY)
        LOG_WARN("FPGA not answering (READY not high and steady), trying again");
    else if (p.tries == 0)
        LOG_WARN("FPGA not answering (%s: %s), trying again", what, fpga_err_str(err));
    p.tries++;
    led_set(LED_FPGA_NO_ANSWER, true);
    p.what = what;
    p.err  = err;
    p.retry_at   = plat_millis() + retry_ms;
    p.retry_wait = true;
    p.ready_wait = false;
    p.ph = P_WAIT;
    show_status(plat_millis(), true);   /* one line, updated in place */
}

static void echo_done(const fpga_cmd_t *cmd, fpga_err_t err)
{
    (void)cmd;
    if (p.ph != P_ECHO) return;         /* probe_start() came in between */
    if (err != FPGA_ERR_NONE) { try_failed("echo", err, PROBE_RETRY_MS); return; }
    p.ph = P_INFO;
}

static void info_done(const fpga_cmd_t *cmd, fpga_err_t err)
{
    (void)cmd;
    if (p.ph != P_INFO_WAIT) return;
    if (err != FPGA_ERR_NONE) { try_failed("INFO", err, PROBE_RETRY_MS); return; }

    cli_status(NULL);
    led_set(LED_FPGA_NO_ANSWER, false);
    if (p.tries)
        LOG_INFO("FPGA answered after %lu failed tr%s", (unsigned long)p.tries,
                 p.tries == 1 ? "y" : "ies");
    const fpga_info_t *in = fpga_link_info();
    LOG_INFO("fpga: screen %ux%u, grid %ux%u cells, N=%u, session 0x%08lX",
             in->width, in->height, in->sim_w, in->sim_h, in->max_cmd,
             (unsigned long)in->session);
    p.tries = 0;
    p.ph = P_DONE;
}

/* ---- public ---------------------------------------------------------- */
void probe_start(void)
{
    p.ph = P_WAIT;
    p.retry_wait = false;
    p.ready_wait = false;
    rdy.init = false;                   /* READY must be steady again first */
}

void probe_stop(void)
{
    /* An ECHO / INFO still in flight finishes, but its callback sees the
     * phase has changed and ignores it (no status line, no retry). */
    if (p.ph != P_STOPPED && p.ph != P_DONE && p.tries)
        LOG_INFO("probing stopped after %lu failed tr%s", (unsigned long)p.tries,
                 p.tries == 1 ? "y" : "ies");
    p.ph = P_STOPPED;
    p.tries = 0;
    cli_status(NULL);
    led_set(LED_FPGA_NO_ANSWER, false);
    led_set(LED_READY_STORM, false);
}

probe_status_t probe_poll(void)
{
    uint32_t now = plat_millis();

    switch (p.ph) {
    case P_WAIT: {
        /* No design loaded (FPGA_DONE low): nothing on the other side can
         * answer yet. Not a failed try: just wait, and say so. */
        if (!plat_fpga_done()) {
            static uint32_t told_at;
            if (now - told_at >= STATUS_EVERY_MS) {
                told_at = now;
                cli_status("waiting for the FPGA to load its design (DONE low)");
            }
            rdy.init     = false;           /* READY must be steady after DONE */
            p.ready_wait = false;
            break;
        }
        bool quiet = ready_quiet(now);  /* tracked while waiting for retry_at too */
        show_status(now, false);
        if (p.retry_wait && (int32_t)(now - p.retry_at) < 0) break;
        if (!quiet) {
            /* READY must be steady within READY_WAIT_MS of when we could
             * send, or that's a failed try (and the wait starts over). A
             * storm has its own status line and is just waited out. */
            if (!p.ready_wait || rdy.storm) { p.ready_wait = true; p.ready_from = now; }
            else if (now - p.ready_from >= READY_WAIT_MS)
                try_failed("READY", FPGA_ERR_NOT_READY, 0);
            break;
        }
        p.ready_wait = false;
        p.pattern++;
        for (unsigned i = 0; i < PROBE_LEN; i++)
            probe_tx[i] = (uint8_t)(i * 37u + p.pattern * 101u);   /* new pattern each try */
        fpga_cmd_t c = fpga_cmd_echo(probe_tx, probe_rx, PROBE_LEN);
        c.done = echo_done;
        if (fpga_submit(&c) == FPGA_OK) p.ph = P_ECHO;
        break;
    }
    case P_INFO: {
        fpga_cmd_t c = fpga_cmd_info();
        c.done = info_done;
        if (fpga_submit(&c) == FPGA_OK) p.ph = P_INFO_WAIT;
        break;                          /* full / INFO already queued: next poll */
    }
    case P_ECHO:
    case P_INFO_WAIT:
        break;                          /* the done callback moves on */
    case P_DONE:
        return PROBE_DONE;
    case P_STOPPED:
        break;                          /* probe_stop(): until probe_start() */
    }
    return PROBE_BUSY;
}
