fredrikr79/TDT4295-datamaskinprosjekt/fpga/src/memory/transactions/mem_txn_deep_power_up.sv

module mem_txn_deep_power_up #(
) (
    input logic reset,
    input logic enable,
    input memory_pkg::state_e current_state,
    output memory_pkg::transaction_output_t out
);

  always_comb begin
    out = '{rwds: 'b0, dq: 'h00, next_state: current_state, read_data: 'h00};
    if (reset) out.next_state = memory_pkg::IDLE;
    else if (enable) begin
      case (current_state)
        memory_pkg::IDLE: out.next_state = memory_pkg::SENDING_CMD;
        memory_pkg::SENDING_CMD: out.next_state = memory_pkg::IDLE;
        default: ;
      endcase
    end
  end

endmodule
