fredrikr79/TDT4295-datamaskinprosjekt/fpga/src/cells/cell_renderer.sv

// If PixelClockDelay is ever set to 1, this code breaks since reading the pixel takes one cycle, and the next will be used to output the pixel to vga
module cell_renderer (
    input wire active_area,
    input vga_sync_params::x_coordinate_t coord_x,
    input vga_sync_params::y_coordinate_t coord_y,

    output wire [cell_pkg::AddrBits-1:0] read_addr,
    input cell_pkg::cell_word_t          read_data,
    output color_pkg::color_t color
);
  import cell_pkg::*;

  localparam color_pkg::color_t BlankColor = '{red: 4'h0, green: 4'h0, blue: 4'h0};

  wire in_grid = active_area
      && (coord_x < vga_sync_params::x_coordinate_t'(GridWidth))
      && (coord_y < vga_sync_params::y_coordinate_t'(GridHeight));

  grid_x_t grid_x;
  grid_y_t grid_y;
  assign grid_x = grid_x_t'(coord_x);
  assign grid_y = grid_y_t'(coord_y);

  assign read_addr = in_grid ? get_word_addr(grid_x, grid_y) : '0;

  material_t material;
  assign material = read_data[get_cell_index(grid_x)];

  always_comb begin
    color = BlankColor;  // VGA requires black outside the active area
    if (in_grid) color = props(material).color;
  end
endmodule
