fredrikr79/TDT4295-datamaskinprosjekt/mcu/hexMCU/src/app/transport_core.c

/* ======================================================================
 * transport_core.c - the platform independent half of the transport
 * layer: backend dispatch and the FPGA_READY edge counter.
 * ====================================================================== */
#define LOG_TAG "xport"

#include "transport.h"
#include "log.h"
#include <stddef.h>

/* Written from interrupt context (or the fake FPGA), read from the main
 * loop. A single word, so the read is atomic on Cortex-M and on x86. */
static volatile uint32_t ready_count;
static volatile uint8_t  ready_status;

void transport_ready_isr(void)
{
    /* Status first: whoever sees the new count must also see its status.
     * Both are volatile, so the compiler keeps this order. */
    ready_status = BACKEND->read_status
                 ? (uint8_t)(BACKEND->read_status() & TRANSPORT_STATUS_MASK)
                 : 0u;
    ready_count++;
}

uint32_t transport_ready_count(void)
{
    return ready_count;
}

uint8_t transport_ready_status(void)
{
    return ready_status;
}

static bool trace;

void transport_set_trace(bool on) { trace = on; }
bool transport_trace_on(void)     { return trace; }

transport_status_t transport_init(void)
{
    if (BACKEND == NULL || BACKEND->init == NULL) {
        LOG_ERR("no backend linked");
        return TRANSPORT_ERR;
    }

    transport_status_t st = BACKEND->init();
    if (st != TRANSPORT_OK) {
        LOG_ERR("backend init failed (%d)", (int)st);
    } else {
        LOG_INFO("backend ready");
    }
    return st;
}

void transport_poll(void)
{
    if (BACKEND->poll) BACKEND->poll();
}
