fredrikr79/TDT4295-datamaskinprosjekt/(commit log)

2026-09-03 pcb: initialize project
    [tdt4295.kicad_pcb, tdt4295.kicad_sch]
2026-09-03 powersupply edit
2026-09-03 pcb: add gitignore
2026-09-03 pcp setup
    [Powersupply-lower.kicad_sch, Powersupply-upper.kicad_sch, Powersupply.kicad_sch, untitled.kicad_sch]
2026-09-03 pcp lower switcher made & implemented
    [Powersupply-lower.kicad_sch]
2026-09-04 pcp lower made
    [Powersupply-lower.kicad_sch]
2026-09-04 fixed unconnected wire and some readability
    [Powersupply-lower.kicad_sch]
2026-09-04 (psp) fixed wrong wires
    [Powersupply-lower.kicad_sch]
2026-09-04 (psp) added text notes for resistors
    [Powersupply-lower.kicad_sch]
2026-09-04 pcb: finish psu upper
    [Powersupply-upper.kicad_sch]
2026-09-04 (psp) add outputs to lower
    [Powersupply-lower.kicad_sch]
2026-09-04 pcb: connect upper and lower
    [Powersupply-lower.kicad_sch, Powersupply-upper.kicad_sch, Powersupply.kicad_sch]
2026-09-07 feat: implement simple SPI slave test module
2026-09-07 Fix linting errors and update to System verilog
    [main.sv]
2026-09-08 pcb: moved powersupply upper & lower to same sheet
    [Powersupply-lower.kicad_sch, Powersupply-upper.kicad_sch, Powersupply.kicad_sch, tdt4295.kicad_sch, test2.kicad_sch, untitled.kicad_sch]
2026-09-08 pcb: add mcu component and sheet
    [MCU.kicad_sch, tdt4295.kicad_sch]
2026-09-08 pcb: initial MCU symbol editing
2026-09-09 pcb: mcu schematic start
    [MCU.kicad_sch]
2026-09-09 pcb: mcu schematic start pt 2
    [MCU.kicad_sch]
2026-09-09 pcb: created the MCU design from the slides
    In case we end up using this I believe it is nice to have it available just in case
    [MCU.kicad_sch, STM32U535CE.kicad_sch]
2026-09-09 refactor: make SPI controller FSM driven
2026-09-09 docs: add descriptive SPI main module comments
2026-09-10 pcb: mcu schematic almost finished2
    [MCU.kicad_sch, Powersupply-lower.kicad_sch, Powersupply-upper.kicad_sch, Powersupply.kicad_sch, STM32U535CE.kicad_sch, tdt4295.kicad_pcb, tdt4295.kicad_sch, test2.kicad_sch]
2026-09-10 fix: move makefile in fpga/sim into maste makefile
    [main.sv]
2026-09-11 started new MCU design impl
    [MCU.kicad_sch, STM32U595ZJT6.kicad_sch]
2026-09-11 initial new mcu design complete
    [STM32U595ZJT6.kicad_sch]
2026-09-11 fixed decoupling capacitors
    [STM32U595ZJT6.kicad_sch]
2026-09-11 started usb_c imp
    [12401826E412A.step, MCU.kicad_sch, usb_c.kicad_sch]
2026-09-13 pcb: usb-c user connected
    [usb_c.kicad_sch]
2026-09-13 pcb: usb user data connected to MCU
    [STM32U595ZJT6.kicad_sch]
2026-09-14 pcb: changes usbc and add input power
    [MCU.kicad_sch, Powersupply.kicad_sch, power_mux.kicad_sch, power_source.kicad_sch, tdt4295.kicad_sch, usb_c.kicad_sch]
2026-09-14 pcb: create fpga
    [fpga.kicad_sch, tdt4295.kicad_sch]
2026-09-14 pcb: start fpga
    [fpga.kicad_sch]
2026-09-14 bug:rework logic to match MCU protocol.
    Add some debug toolings, fix skipped clock cycles and logical issues related to state transitions
    [arty_a7_35T.xdc]
2026-09-15 pcb: usbc power supply + mux
    [power_mux.kicad_sch]
2026-09-15 Update sync params to use correct resolution
    [vga_sync_params.sv]
2026-09-15 Make simulator use pixel pulse from vga controller
    This is better since now the simulator doesn't need to add arbituary
    ticks in the main loop.
    [main.sv, tb_main.sv, vga_controller.sv]
2026-09-15 pcb: remove test2
    [test2.kicad_sch]
2026-09-15 pcb: add altium sram symbol/model
    [BGA24C100P5X5_600X800X100.PcbLib, S70KS1283GABHB023.SchLib]
2026-09-15 pcb: add sram sheet
    [sram.kicad_sch, tdt4295.kicad_sch]
2026-09-15 add microsd
    [MCU.kicad_sch, Powersupply-lower.kicad_sch, Powersupply-upper.kicad_sch, Powersupply.kicad_sch, STM32U535CE.kicad_sch, STM32U595ZJT6.kicad_sch, fpga.kicad_sch, power_mux.kicad_sch]
2026-09-15 shield -> ground
    [MCU.kicad_sch, tdt4295.kicad_sch]
2026-09-16 pcb: add VCP w/ESD protection
    [MCU.kicad_sch, Powersupply-lower.kicad_sch, Powersupply-upper.kicad_sch, Powersupply.kicad_sch, STM32U535CE.kicad_sch, STM32U595ZJT6.kicad_sch, fpga.kicad_sch, power_mux.kicad_sch]
2026-09-16 pcb: add sram and flash to fpga
    [fpga.kicad_sch]
2026-09-16 pcb: removed CC line resistors
    [usb_c.kicad_sch]
2026-09-16 pcb/fpga: add jtag
    [fpga.kicad_sch]
2026-09-17 add SPI backup sd card
    [MCU.kicad_sch]
2026-09-17 sheet cleanup
    [MCU.kicad_sch, Powersupply.kicad_sch]
2026-09-17 pcb/fpga: change sram module to 3v3
    [BGA24C100P5X5_600X800X100.PcbLib, S70KL1283GABHI020.SchLib, S70KS1283GABHB023.SchLib, fpga.kicad_sch]
2026-09-17 pcb: add rst button
    [MCU.kicad_sch]
2026-09-17 pcb/fpga: change 75tcsg to 50tftg
    [fpga.kicad_sch]
2026-09-17 pcb: add fpga to root
    [fpga.kicad_sch, tdt4295.kicad_sch]
2026-09-17 fix: apply signal pulse fix to be able to simulate vga
    [main.sv, tb_main.sv]
2026-09-17 fix: change sync params to have letterbox on top and bottom of graphics because of the speed of our current clock
    [vga_controller.sv, vga_sync_params.sv]
2026-09-17 fpga connection and cleanup
    [MCU.kicad_sch, tdt4295.kicad_sch]
2026-09-17 pcb/fpga: put all on sheet and add dont-cares
    [fpga.kicad_sch]
2026-09-17 fix annotation
    [MCU.kicad_sch, Powersupply.kicad_sch, fpga.kicad_sch, power_source.kicad_sch, usb_c.kicad_sch]
2026-09-17 added vddio pins and decoupling condensator
    [MCU.kicad_sch, Powersupply-lower.kicad_sch, Powersupply-upper.kicad_sch, Powersupply.kicad_sch, STM32U535CE.kicad_sch, STM32U595ZJT6.kicad_sch, fpga.kicad_sch, power_mux.kicad_sch]
2026-09-17 removed extra pins
    [MCU.kicad_sch]
2026-09-17 pcb/fpga: remove EXn, add proper crystal
    [fpga.kicad_sch]
2026-09-17 pcb/fpga: prettify gnd
    [fpga.kicad_sch]
2026-09-17 pcb/fpga: fix label position
    [fpga.kicad_sch]
2026-09-17 started removing errors from check
    [MCU.kicad_sch, Powersupply-lower.kicad_sch, Powersupply-upper.kicad_sch, Powersupply.kicad_sch, STM32U535CE.kicad_sch, STM32U595ZJT6.kicad_sch, fpga.kicad_sch, power_mux.kicad_sch]
2026-09-18 fixed erc errors
    [MCU.kicad_sch, Powersupply.kicad_sch, fpga.kicad_sch]
2026-09-18 removed sd card esd protection
    [MCU.kicad_sch]
2026-09-18 pcb: fix erc
    [Powersupply.kicad_sch, fpga.kicad_sch]
2026-09-18 pcb: satisfy ERC warnings and errors
    [MCU.kicad_sch, Powersupply.kicad_sch, fpga.kicad_sch, power_source.kicad_sch, usb_c.kicad_sch]
2026-09-18 pcb: change sram to dpb model
    [BGA24C100P5X5_600X800X100.PcbLib, S70KL1283DPBHV020.SchLib, S70KL1283GABHI020.SchLib, fpga.kicad_sch]
2026-09-18 added mcu rgb led
    [MCU.kicad_sch]
2026-09-18 layout prep
    [MCU.kicad_sch, Powersupply.kicad_sch, fpga.kicad_sch, power_source.kicad_sch, usb_c.kicad_sch]
2026-09-18 pcb/fpga: fix vga
    [fpga.kicad_sch]
2026-09-18 updates labels
    [MCU.kicad_sch, Powersupply.kicad_sch, fpga.kicad_sch, power_source.kicad_sch, usb_c.kicad_sch]
2026-09-18 add footprint to new resistors & import to layout
    [tdt4295.kicad_pcb]
2026-09-18 started layout
    [fpga.kicad_sch, tdt4295.kicad_pcb]
2026-09-20 pcb: finalize erc
    [fpga.kicad_sch, tdt4295.kicad_pcb, usb_c.kicad_sch]
2026-09-20 pcb: pds rough placement
    [tdt4295.kicad_pcb, usb_c.kicad_sch]
2026-09-20 pcb: wip
    [tdt4295.kicad_pcb]
2026-09-20 pcb: pds usb and jumper layout
    [tdt4295.kicad_pcb]
2026-09-20 pcb: mcu, sd card, jtag layout
    [MCU.kicad_sch, Powersupply.kicad_sch, tdt4295.kicad_pcb]
2026-09-20 pcb: attempt fpga-sram
    [tdt4295.kicad_pcb]
2026-09-20 pcb: fpga neat grid
    [tdt4295.kicad_pcb]
2026-09-20 pcb: connect sram+fpga+pullups+clock
    [tdt4295.kicad_pcb]
2026-09-20 pcb: wip fpga decoupling capacitors
    [tdt4295.kicad_pcb]
2026-09-21 pcb: vga
    [tdt4295.kicad_pcb]
2026-09-21 pcb: add board and pwr/gnd planes
    [tdt4295.kicad_pcb]
2026-09-21 pcb: address feedback
    - make rgb565 resistor ladder
    - add 1v0 diode
    - clean up pwr flags
    - remove unused mcu-sd spi
    - use labels in mcu
    - fix broken rgb diode
    - connect usblc pin 5 to vbus
    [MCU.kicad_sch, Powersupply.kicad_sch, fpga.kicad_sch, power_source.kicad_sch, usb_c.kicad_sch]
2026-09-21 Make new implementation of the vga circuit
    This circuit is based on the youtube series by https://www.youtube.com/@anassalaheddin1258
    Also made the parameters general for both C++ and Verilog.
2026-09-21 Fix rebase conflict I oversaw in previous commit
    [main.sv, vga_controller.sv]
2026-09-22 fix usb symbol
    [power_source.kicad_sch, usb_c.kicad_sch]
2026-09-22 pcb: simplify mcu led
    [MCU.kicad_sch, usb_c.kicad_sch]
2026-09-22 add pull-up sd card
    [MCU.kicad_sch]
2026-09-22 pcb/layout: usbs and pds
    [Powersupply.kicad_sch, power_source.kicad_sch, tdt4295.kicad_pcb, usb_c.kicad_sch]
2026-09-22 pcb: wip fan out dog bone
    [MCU.kicad_sch, tdt4295.kicad_pcb]
2026-09-22 pcb: wip layout
    [tdt4295.kicad_pcb]
2026-09-22 pcb: place everything approximately correct
    [tdt4295.kicad_pcb]
2026-09-22 pcb: place board
    [tdt4295.kicad_pcb]
2026-09-22 pcb: finish vga
    [MCU.kicad_sch, tdt4295.kicad_pcb]
2026-09-22 pcb: connect sram
    [tdt4295.kicad_pcb]
2026-09-22 pcb: mcu+fpga done
    [tdt4295.kicad_pcb]
2026-09-22 pcb: finish
    [tdt4295.kicad_pcb]
2026-09-22 fix: repair files after merge with main
    [main.sv, vga_sync_params.sv]
2026-09-23 changed footprint of J3
    [Powersupply.kicad_sch]
2026-09-23 added new jumper
    [Powersupply.kicad_sch, usb_c.kicad_sch]
2026-09-23 added new jumper complete
    [Powersupply.kicad_sch, power_source.kicad_sch, usb_c.kicad_sch]
2026-09-23 test: add new MCU->FPGA SPI testbench
2026-09-23 feat: update spi module to fit mandatory MCU hardware protocol
    NB! bug with undriven first TX byte
2026-09-24 pcb: plot symbols and layout
2026-09-24 fix: fix sync, reset, delay and FIFO emptying issues
    This marks a completly functional driver
2026-09-24 docs: add docs for SPI protocol
2026-09-24 chore: rename spi module
2026-09-25 Make spi verilog files to system verilog
2026-09-25 Format spi files
2026-09-27 refactor: split spi module into discrete state-region handlers
2026-09-27 fix: add explicit error handling
    [spi_fsm.sv, spi_processor.sv]
2026-09-27 fix: logical bugs post refactor
    [spi.sv, spi_fsm.sv, spi_pck.sv, spi_processor.sv, spi_tx.sv, tb_spi.sv]
2026-09-27 fix: synth fault caused by illegal opcode enum assignment
    [spi_processor.sv]
2026-09-28 new VGA model and footprint added
    [L77HDE15SD1CH4FVGA.step, Powersupply.kicad_sch, fpga.kicad_sch, tdt4295.kicad_pcb]
2026-09-28 feat: add more materials
2026-09-28 fix: revert tx_load and tx_arm relaxation
    relaxation of in_empty contraint for tx_load and tx_armed caused early FSM transitions and data loss. Rewrite to force in_fifo emptying before transitioning from `ST_BUSY`.
    [spi_fsm.sv, spi_processor.sv, spi_tx.sv]
2026-09-28 fixed vga shield and tpsx94 footprint
    [Powersupply.kicad_sch, tdt4295.kicad_pcb]
2026-09-28 fix: make fpga synthesize grid of pixels to BRAM instead of flipflops
    [cell_memory.sv, vga_sync_params.sv]
2026-09-28 added 3d model for powersupply
    [PWP0014K.stp, PWP0016C.stp, Powersupply.kicad_sch, tdt4295.kicad_pcb]
2026-09-29 moved buttons closer together and added fpga 3d model
    [FTFTG256_XIL.step, tdt4295.kicad_pcb]
2026-09-29 added sd card connector 3d model
    [sd_card_model.stp, tdt4295.kicad_pcb]
2026-09-29 fixed psd footprintgs and some routing
    [Powersupply.kicad_sch, power_source.kicad_sch, tdt4295.kicad_pcb]
2026-09-29 fixed many errors and violations
    [tdt4295.kicad_pcb]
2026-09-29 fixed all unconnected errors
    [tdt4295.kicad_pcb]
2026-09-29 labeled usb data +/- conn and diff-paired them
    [tdt4295.kicad_pcb, usb_c.kicad_sch]
2026-09-30 fixed led footprint and model
    [APTF1616.STEP, tdt4295.kicad_pcb]
2026-09-30 fixed all unconnected wires warnings
    [tdt4295.kicad_pcb]
2026-09-30 fixed usb-c error
    [tdt4295.kicad_pcb]
2026-09-30 Removed drivers as it can be regenerated
2026-09-30 added drivers/ to gitignoer
2026-09-30 pcb/fpga: add user button
    [MCU.kicad_sch, fpga.kicad_sch, tdt4295.kicad_pcb]
2026-09-30 power-cable to FPGA improvement (experimental)
    [tdt4295.kicad_pcb]
2026-09-30 fpga button
    [tdt4295.kicad_pcb]
2026-09-30 pcb: add logo and names
    [tdt4295.kicad_pcb]
2026-09-30 pcb: fix drc
    [tdt4295.kicad_pcb]
2026-09-30 feat: integrate INFO command into SPI controller
2026-09-30 test: update SPI testbench to test INFO
2026-09-30 pcb: clear all DRCs
    [tdt4295.kicad_pcb]
2026-10-01 usb-c diff pair + 3d models + redundant wire deletion
    [tdt4295.kicad_pcb]
2026-10-01 pcb/fpga: fix power supply
    [tdt4295.kicad_pcb]
2026-10-01 pcb: add ground pours
    [tdt4295.kicad_pcb]
2026-10-01 redid ground pour
    [tdt4295.kicad_pcb]
2026-10-01 redid diff pair usb
    [tdt4295.kicad_pcb, usb_c.kicad_sch]
2026-10-01 updated usb wires to match width
    [tdt4295.kicad_pcb]
2026-10-01 forgot U8 net connection
    [tdt4295.kicad_pcb]
2026-10-02 fixed drc error
    [tdt4295.kicad_pcb]
2026-10-06 fix: use run signaling for sub module tasks for synthesizability
    [info.sv, spi.sv, spi_processor.sv, spi_tx.sv]
2026-10-07 fix: constrain read pos for INFO TX to actual length of data
    [info.sv]
2026-10-07 fix: spi_mcu boot handshake hotpatch
    Resolve
    [info.sv, spi_processor.sv]
2026-10-08 refactor: add some comments within vga_sync_params as well as move velocity.sv to its own folder
2026-10-08 feat: link spi controller to main
2026-10-12 feat: add write_line and read_line commands to spi processor
2026-10-13 fix: fix bug with led-input not specifying size, and set pixels for HUD layer to always transparent
2026-10-13 fix: insane bug with vivado synthesiz that optimizes away a nested return in the cell-material LUT for colors, and another bug where vivado optimizes away instantaneous assignments of automatic logic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
2026-10-14 chore: attach signals in root modules
2026-10-15 made R60 to do not solder
2026-10-16 feat: connect sprite lut to spi (write) and hud (write)
2026-10-20 fix: comment away spi for now, since it is missing implementaiton
2026-10-20 fix: il explain in person i guess
2026-10-20 feat: add main level wiring across modules
2026-10-20 feat: add mem_map_pkg that holds pointers to cells, gol, frame buffers and hud in SRAM memory, as well as useful helper functions to get addresses based on xy coordinates
2026-10-21 test: add tb's for all spi command handlers
2026-10-22 docs: write documentation for all SPI commands
2026-10-22 Implemented new fpga commands to be the same as current fpga
2026-10-26 Remove portal exits & update velocity box
2026-10-26 feat: declare and wire up MUX'ed SPI error lines
2026-10-26 feat: add critical error in main for non-spi modules
    Allow modules outside the spi domain to report unrecoverable faults and thereby request an FPGA reset from the MCU
2026-10-28 feat: remove gol SRAM memory references and add more helper funcitons for framebuffer memory referencing
2026-10-28 feat: add spi-required definitions to main, and in/out buffers for spi so sim-vga is able to run without depending on vivado ips
2026-10-29 feat: add pseudo-random direction sampler
2026-11-01 feat: add blast resistance to materials
2026-11-01 feat: add framebuffer line-fetching from memory and streaming out to vga, using cell-layer as layer in current compositor implementation
2026-11-02 fix: add blast resistance and fix delay issues
2026-11-02 Update velocity box generation
2026-11-02 Move portal checking and velocity box creation into update player
2026-11-02 Change update player to send velocity box through function instead of return
2026-11-02 Add terminal velocity from gravity and fix movement bug
2026-11-04 refactor: make variable names for the memory-based variables for SPI follow the same naming that fb uses
2026-11-04 Moved probe to own file
2026-11-05 fix: major rework of timing logic for SPI and parameter setup.
    spi tx timing has miraclously worked for echo and info, but is in a timing race for any other handler. rework logic for TX, and fix opcode popping errors, illegal error handling states and more
2026-11-08 feat: make spi listen to mem_access_policy before trying to access memory
2026-11-09 Initialize velocity box ID box
2026-11-09 led moment
2026-11-09 led test
2026-11-09 feat: create example testing file with blinking LED and update constraint file for LED pins
2026-11-10 Led cleanup and test
2026-11-10 feat: add colour palettes to all materials
2026-11-11 fix: do color lookup based on color instead of material_t
    BREAKING_CHANGE breaks tb's reliant on the old pallette system.
2026-11-12 Fix moving further than velocitybox
2026-11-12 fix: base outputs on the delayed output instead of the current output
2026-11-12 fix: spi handlers wait on mem_busy
2026-11-13 fix: fixed bug with framebuffer not switching early enough, sim_buffers dropping commits when compositor busy and hud_line_buffer clearing row_ready on pulse_frame_restart causing deadlock
