fredrikr79/TDT4295-datamaskinprosjekt/(notices)

Notices in the files:
mcu/hexMCU/cube/hexU59/Core/Inc/main.h:
Copyright (c) 2026 STMicroelectronics.
All rights reserved.
This software is licensed under terms that can be found in the LICENSE file
